adamgreig/linetime/README.md

# Linetime

Measure the line time. As precisely and accurately as feasible.
