adamgreig/linetime/hardware/sims/mains_lpf.csv

Title: mains lpf
Date: Mon Dec 19 00:59:21 2016
Plotname: AC Analysis
Flags: complex
No. Variables: 4
No. Points: 8001
Variables:
 | 0 | frequency | frequency grid=3
 | 1 | v(out) | voltage
 | 2 | db(v(out)/v(src)) | notype
 | 3 | ph(out) | voltage
Values:
0 | 1.000000000000000e+00,0.000000000000000e+00
 | 1.390163929116547e+00,-8.591466466225699e-05
 | -1.570659671680307e+01,0.0
 | -3.540983602049155e-03,0.0
1 | 1.002305238077900e+00,0.000000000000000e+00
 | 1.390163929092038e+00,-8.611271841716826e-05
 | -1.570659671687963e+01,0.0
 | -3.549146412260961e-03,0.0
2 | 1.004615790278395e+00,0.000000000000000e+00
 | 1.390163929067417e+00,-8.631122873312631e-05
 | -1.570659671695655e+01,0.0
 | -3.557328039693545e-03,0.0
3 | 1.006931668851804e+00,0.000000000000000e+00
 | 1.390163929042681e+00,-8.651019666261291e-05
 | -1.570659671703383e+01,0.0
 | -3.565528527725078e-03,0.0
4 | 1.009252886076684e+00,0.000000000000000e+00
 | 1.390163929017832e+00,-8.670962326053621e-05
 | -1.570659671711146e+01,0.0
 | -3.573747919833734e-03,0.0
5 | 1.011579454259898e+00,0.000000000000000e+00
 | 1.390163928992868e+00,-8.690950958423606e-05
 | -1.570659671718944e+01,0.0
 | -3.581986259597908e-03,0.0
6 | 1.013911385736679e+00,0.000000000000000e+00
 | 1.390163928967789e+00,-8.710985669348970e-05
 | -1.570659671726780e+01,0.0
 | -3.590243590696457e-03,0.0
7 | 1.016248692870695e+00,0.000000000000000e+00
 | 1.390163928942594e+00,-8.731066565051752e-05
 | -1.570659671734651e+01,0.0
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
 | -1.570659723946124e+01,0.0
 | -2.018942257629462e-02,0.0
757 | 5.714786366718442e+00,0.000000000000000e+00
 | 1.390163761018468e+00,-4.909838949434654e-04
 | -1.570659724195029e+01,0.0
 | -2.023596399812239e-02,0.0
758 | 5.727960309858063e+00,0.000000000000000e+00
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
