adamgreig/linetime/case/lcd-bracket/bracket.png

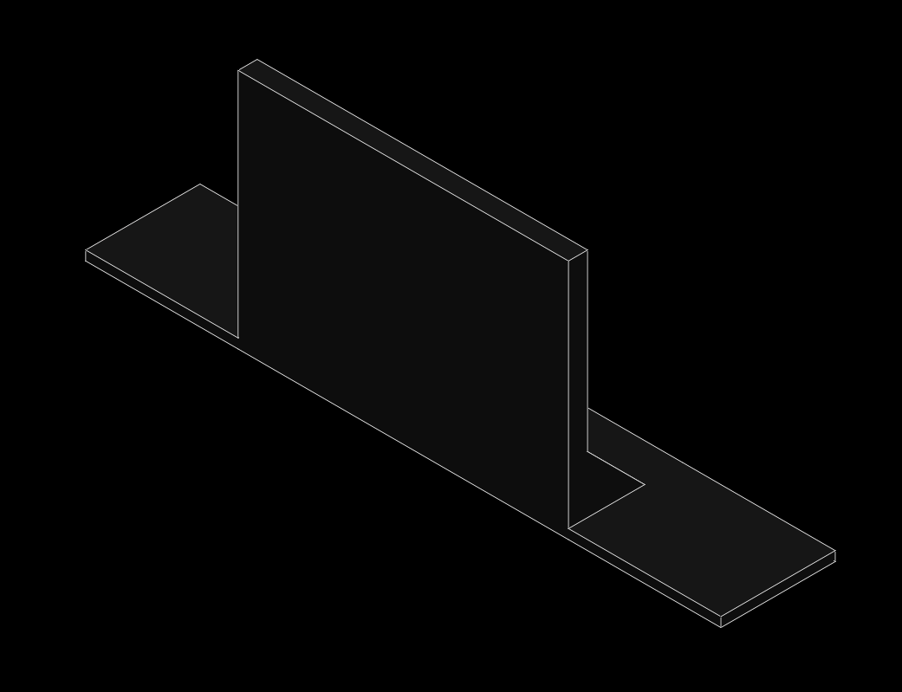
case/lcd-bracket/bracket.png
