adamgreig/linetime/case/back-panel/back-panel.dxf

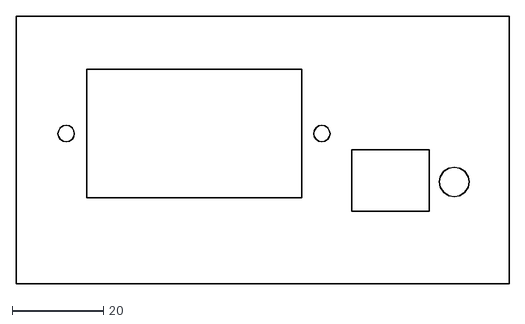
[picture p2: CAD file, 2017-03-29]
case/back-panel/back-panel.dxf
108.0 x 58.6
