adamgreig/linetime/case/front-panel/front_panel.dxf

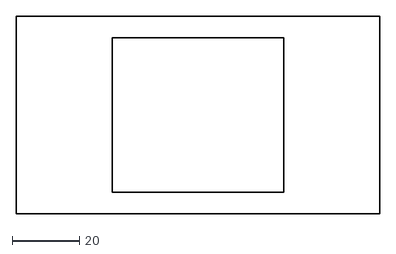
[picture p3: CAD file, 2017-03-29]
case/front-panel/front_panel.dxf
108.0 x 58.6
