adamgreig/linetime/case/lcd-bracket/bracket.stl

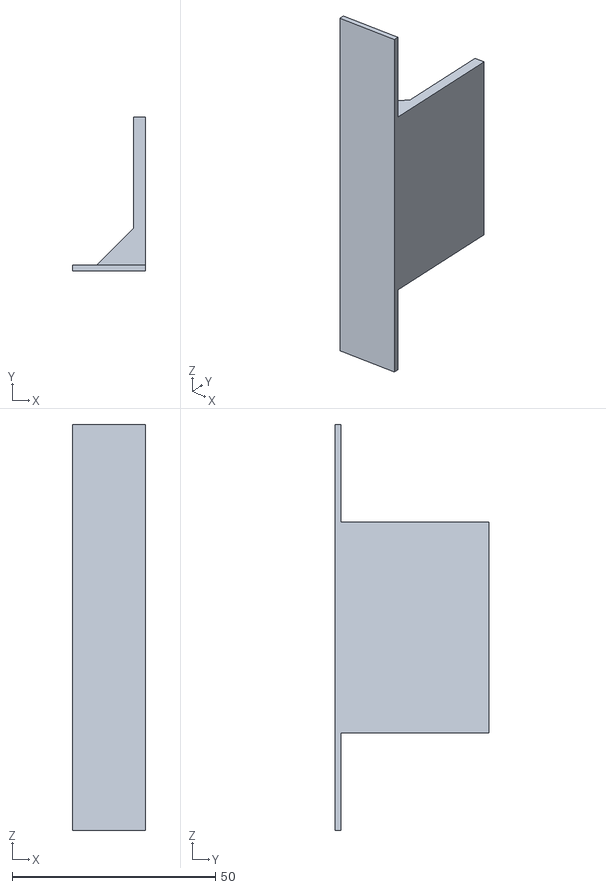
[picture p4: CAD file, 2017-03-29]
case/lcd-bracket/bracket.stl
18.0 x 38.0 x 100.0
