adamgreig/linetime/case/back-panel/export.dxf

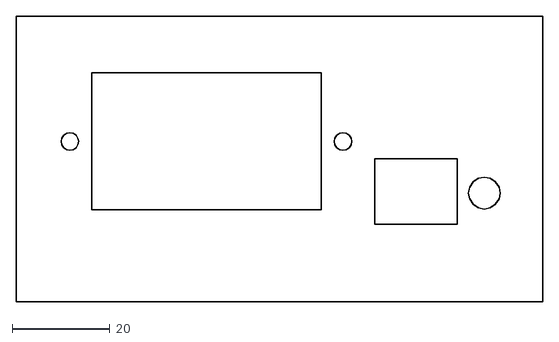
[picture p5: CAD file, 2017-03-29]
case/back-panel/export.dxf
108.0 x 58.6
