adamgreig/linetime/case/front-panel/export.dxf

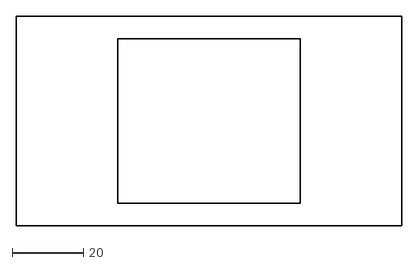
[picture p6: CAD file, 2017-03-29]
case/front-panel/export.dxf
108.0 x 58.6
