adamgreig/linetime/case/back-panel/back-panel.pdf

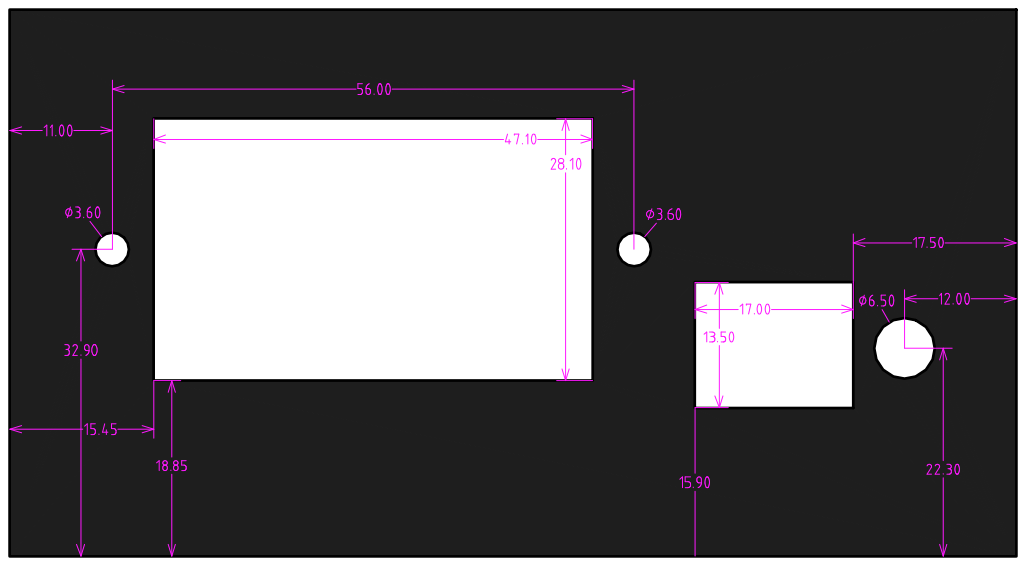
[picture p12: page 1]
