adamgreig/linetime/case/front-panel/front_panel.pdf

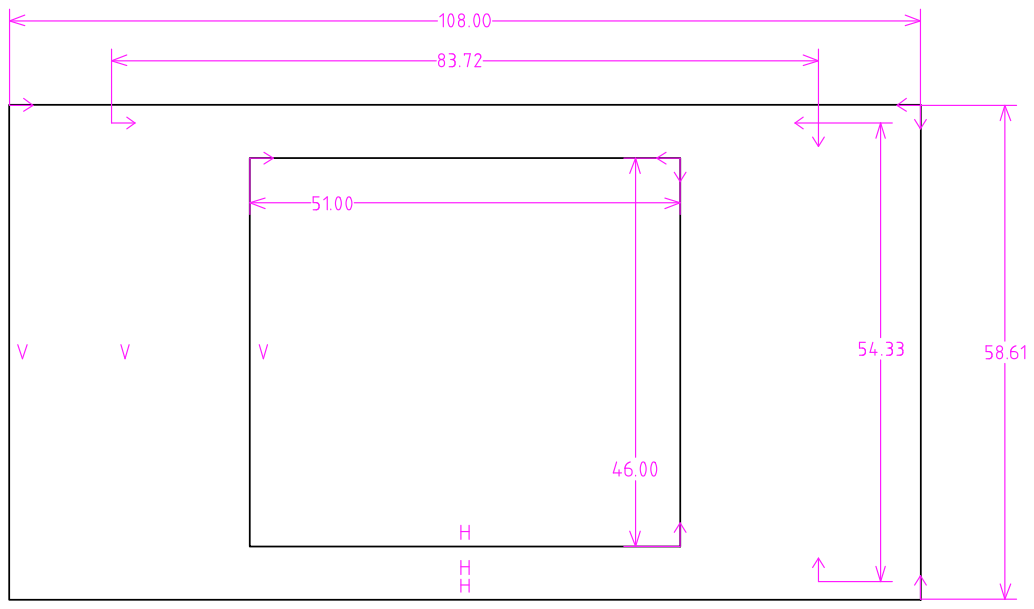
[picture p13: page 1]
