adamgreig/linetime/hardware/linetime.kicad_pcb

## KiCad design hardware/linetime.kicad_pcb (2016-12-19)

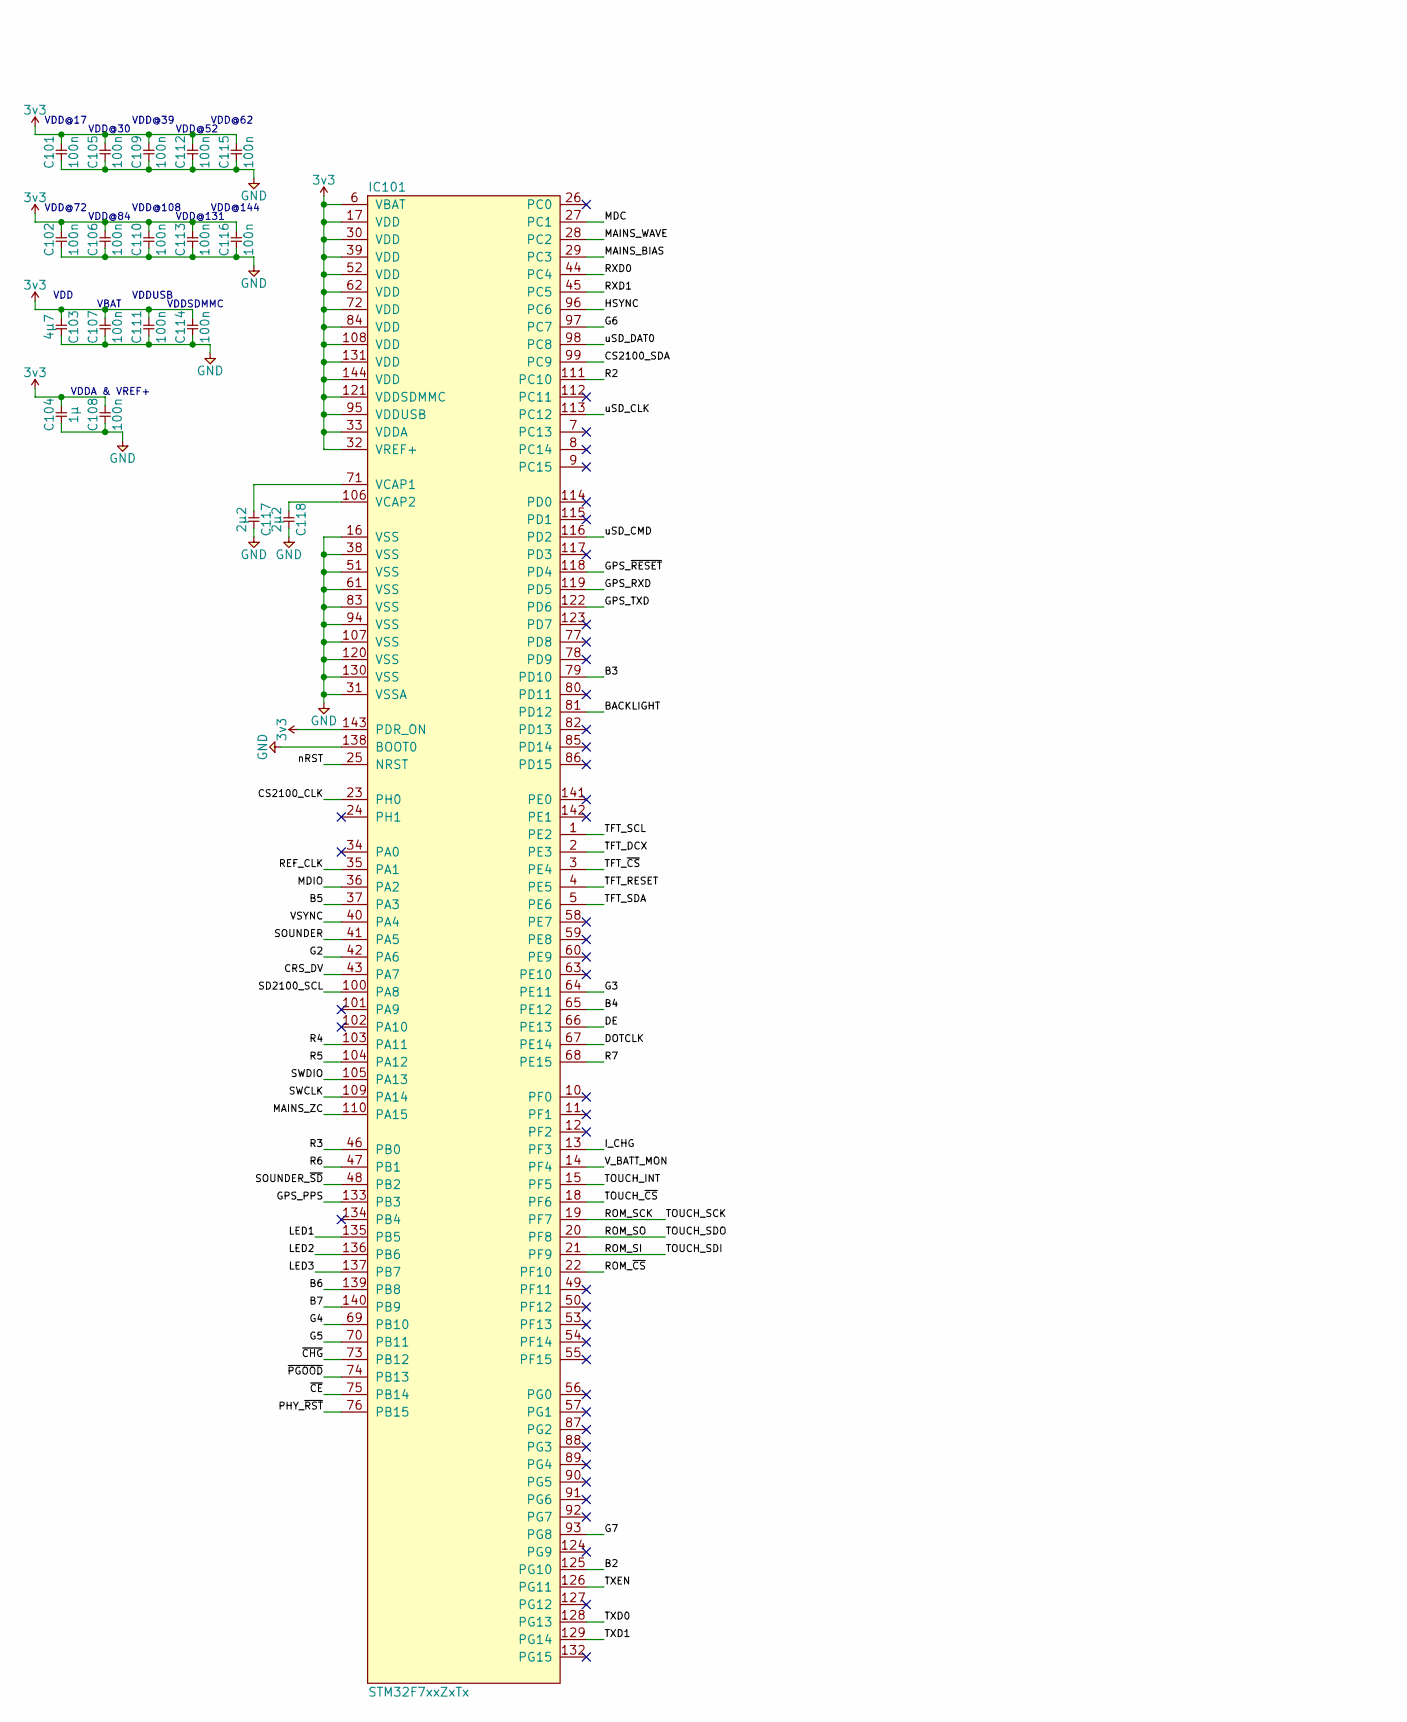
[picture p14: schematic linetime.sch, part in row 1, column 1]

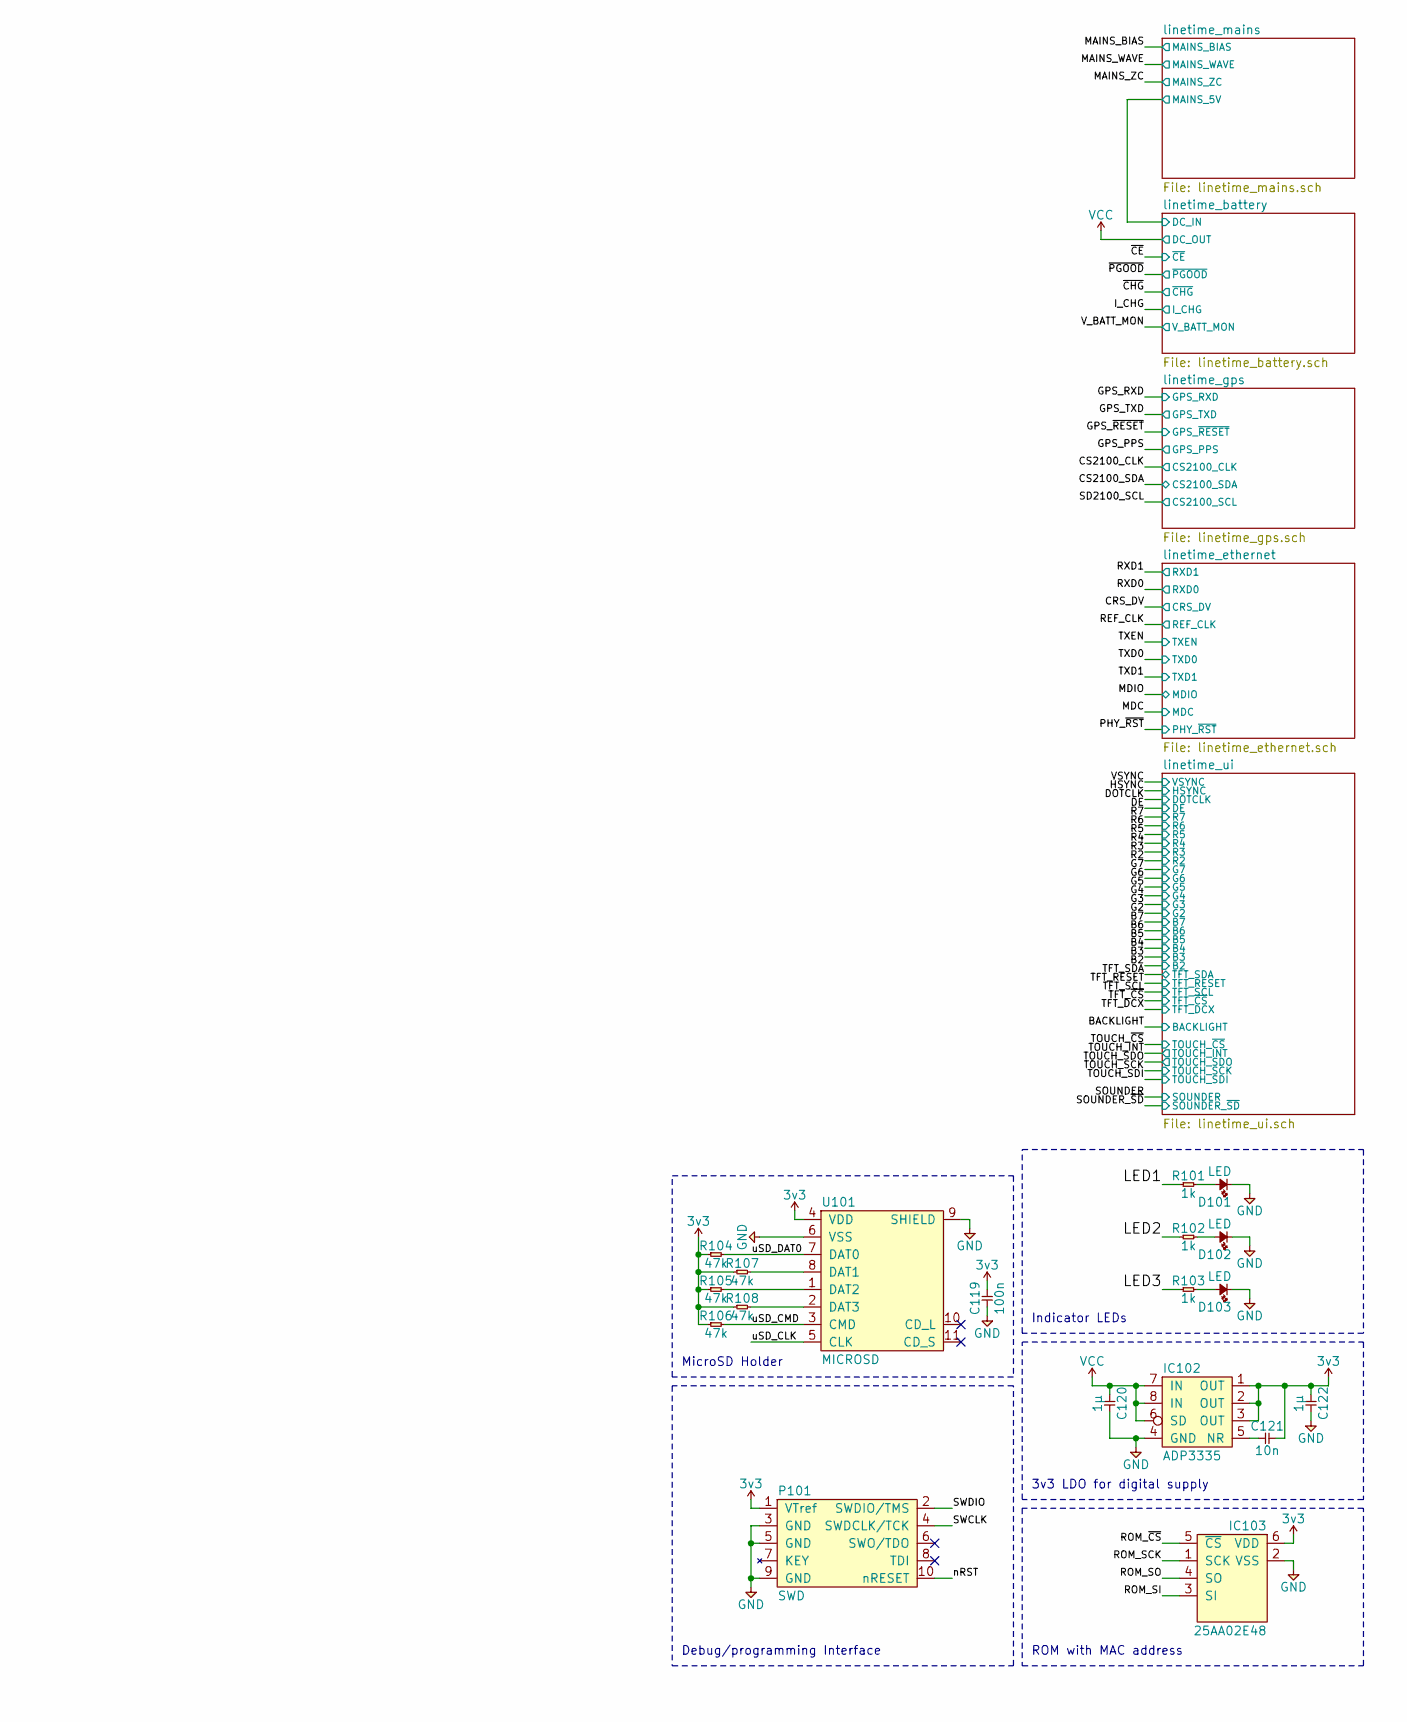
[picture p15: schematic linetime.sch, part in row 1, column 2]

Parts:
C101, C102, C105, C106, C107, C108, C109, C110, C111, C112, C113, C114, C115, C116, C119: 100n; 0603
C103: 4µ7; 0603
C104, C120, C122: 1µ; 0603
C117, C118: 2µ2; 0603
C121: 10n; 0603
D101, D102, D103: LED; 0603-LED
IC101: STM32F7xxZxTx; LQFP-144; Farnell 2535499
IC102: ADP3335; MSOP-8; Farnell 2067775
IC103: 25AA02E48; SOT-23-6; Farnell 1700995
P101: SWD; FTSH-105-01-F-D-K
R101, R102, R103: 1k; 0603
R104, R105, R106, R107, R108: 47k; 0603
U101: MICROSD; MICROSD_MOLEX_503398-1892; Farnell 2358234

Connections:
3v3: C101.1, C102.1, C103.1, C104.1, C105.1, C106.1, C107.1, C108.1, C109.1, C110.1, C111.1, C112.1, C113.1, C114.1, C115.1, C116.1, C119.1, C121.2, C122.1, IC101.6 (VBAT), IC101.17 (VDD), IC101.30 (VDD), IC101.32 (VREF+), IC101.33 (VDDA), IC101.39 (VDD), IC101.52 (VDD), IC101.62 (VDD), IC101.72 (VDD), IC101.84 (VDD), IC101.95 (VDDUSB), IC101.108 (VDD), IC101.121 (VDDSDMMC), IC101.131 (VDD), IC101.143 (PDR_ON), IC101.144 (VDD), IC102.1 (OUT), IC102.2 (OUT), IC102.3 (OUT), IC103.6 (VDD), P101.1 (VTref), R104.1, R105.1, R106.1, R107.1, R108.1, U101.4 (VDD); also elsewhere on the board
/B2: IC101.125 (PG10); also elsewhere on the board
/B3: IC101.79 (PD10); also elsewhere on the board
/B4: IC101.65 (PE12); also elsewhere on the board
/B5: IC101.37 (PA3); also elsewhere on the board
/B6: IC101.139 (PB8); also elsewhere on the board
/B7: IC101.140 (PB9); also elsewhere on the board
/BACKLIGHT: IC101.81 (PD12); also elsewhere on the board
/CRS_DV: IC101.43 (PA7); also elsewhere on the board
/CS2100_CLK: IC101.23 (PH0); also elsewhere on the board
/CS2100_SDA: IC101.99 (PC9); also elsewhere on the board
/DE: IC101.66 (PE13); also elsewhere on the board
/DOTCLK: IC101.67 (PE14); also elsewhere on the board
/G2: IC101.42 (PA6); also elsewhere on the board
/G3: IC101.64 (PE11); also elsewhere on the board
/G4: IC101.69 (PB10); also elsewhere on the board
/G5: IC101.70 (PB11); also elsewhere on the board
/G6: IC101.97 (PC7); also elsewhere on the board
/G7: IC101.93 (PG8); also elsewhere on the board
/GPS_PPS: IC101.133 (PB3); also elsewhere on the board
/GPS_RXD: IC101.119 (PD5); also elsewhere on the board
/GPS_TXD: IC101.122 (PD6); also elsewhere on the board
/GPS_~RESET: IC101.118 (PD4); also elsewhere on the board
/HSYNC: IC101.96 (PC6); also elsewhere on the board
/I_CHG: IC101.13 (PF3); also elsewhere on the board
/LED1: IC101.135 (PB5), R101.1
/LED2: IC101.136 (PB6), R102.1
/LED3: IC101.137 (PB7), R103.1
/MAINS_BIAS: IC101.29 (PC3); also elsewhere on the board
/MAINS_WAVE: IC101.28 (PC2); also elsewhere on the board
/MAINS_ZC: IC101.110 (PA15); also elsewhere on the board
/MDC: IC101.27 (PC1); also elsewhere on the board
/MDIO: IC101.36 (PA2); also elsewhere on the board
/PHY_~RST: IC101.76 (PB15); also elsewhere on the board
/R2: IC101.111 (PC10); also elsewhere on the board
/R3: IC101.46 (PB0); also elsewhere on the board
/R4: IC101.103 (PA11); also elsewhere on the board
/R5: IC101.104 (PA12); also elsewhere on the board
/R6: IC101.47 (PB1); also elsewhere on the board
/R7: IC101.68 (PE15); also elsewhere on the board
/REF_CLK: IC101.35 (PA1); also elsewhere on the board
/ROM_SCK: IC101.19 (PF7), IC103.1 (SCK); also elsewhere on the board
/ROM_SI: IC101.21 (PF9), IC103.3 (SI); also elsewhere on the board
/ROM_SO: IC101.20 (PF8), IC103.4 (SO); also elsewhere on the board
/ROM_~CS: IC101.22 (PF10), IC103.5 (~CS)
/RXD0: IC101.44 (PC4); also elsewhere on the board
/RXD1: IC101.45 (PC5); also elsewhere on the board
/SD2100_SCL: IC101.100 (PA8); also elsewhere on the board
/SOUNDER: IC101.41 (PA5); also elsewhere on the board
/SOUNDER_~SD: IC101.48 (PB2); also elsewhere on the board
/SWCLK: IC101.109 (PA14), P101.4 (SWDCLK/TCK)
/SWDIO: IC101.105 (PA13), P101.2 (SWDIO/TMS)
/TFT_DCX: IC101.2 (PE3); also elsewhere on the board
/TFT_RESET: IC101.4 (PE5); also elsewhere on the board
/TFT_SCL: IC101.1 (PE2); also elsewhere on the board
/TFT_SDA: IC101.5 (PE6); also elsewhere on the board
/TFT_~CS: IC101.3 (PE4); also elsewhere on the board
/TOUCH_INT: IC101.15 (PF5); also elsewhere on the board
/TOUCH_~CS: IC101.18 (PF6); also elsewhere on the board
/TXD0: IC101.128 (PG13); also elsewhere on the board
/TXD1: IC101.129 (PG14); also elsewhere on the board
/TXEN: IC101.126 (PG11); also elsewhere on the board
/VSYNC: IC101.40 (PA4); also elsewhere on the board
/V_BATT_MON: IC101.14 (PF4); also elsewhere on the board
/nRST: IC101.25 (NRST), P101.10 (nRESET)
/uSD_CLK: IC101.113 (PC12), U101.5 (CLK)
/uSD_CMD: IC101.116 (PD2), R106.2, U101.3 (CMD)
/uSD_DAT0: IC101.98 (PC8), R104.2, U101.7 (DAT0)
/~CE: IC101.75 (PB14); also elsewhere on the board
/~CHG: IC101.73 (PB12); also elsewhere on the board
/~PGOOD: IC101.74 (PB13); also elsewhere on the board
GND: C101.2, C102.2, C103.2, C104.2, C105.2, C106.2, C107.2, C108.2, C109.2, C110.2, C111.2, C112.2, C113.2, C114.2, C115.2, C116.2, C117.2, C118.2, C119.2, C120.2, C122.2, D101.1, D102.1, D103.1, IC101.16 (VSS), IC101.31 (VSSA), IC101.38 (VSS), IC101.51 (VSS), IC101.61 (VSS), IC101.83 (VSS), IC101.94 (VSS), IC101.107 (VSS), IC101.120 (VSS), IC101.130 (VSS), IC101.138 (BOOT0), IC102.4 (GND), IC103.2 (VSS), P101.3 (GND), P101.5 (GND), P101.9 (GND), U101.6 (VSS), U101.9 (SHIELD); also elsewhere on the board
unnamed: C117.1, IC101.71 (VCAP1)
unnamed: C118.1, IC101.106 (VCAP2)
unnamed: C121.1, IC102.5 (NR)
unnamed: D101.2, R101.2
unnamed: D102.2, R102.2
unnamed: D103.2, R103.2
unnamed: R105.2, U101.1 (DAT2)
unnamed: R107.2, U101.8 (DAT1)
unnamed: R108.2, U101.2 (DAT3)
VCC: C120.1, IC102.6 (SD), IC102.7 (IN), IC102.8 (IN); also elsewhere on the board

Notes on the sheet:
3v3 LDO for digital supply
ROM with MAC address
MicroSD Holder
Debug/programming Interface
VDDA & VREF+
VDDUSB
VDDSDMMC
VBAT
VDD
VDD@17
VDD@30
VDD@39
VDD@52
VDD@62
VDD@72
VDD@84
VDD@108
VDD@131
VDD@144
Indicator LEDs

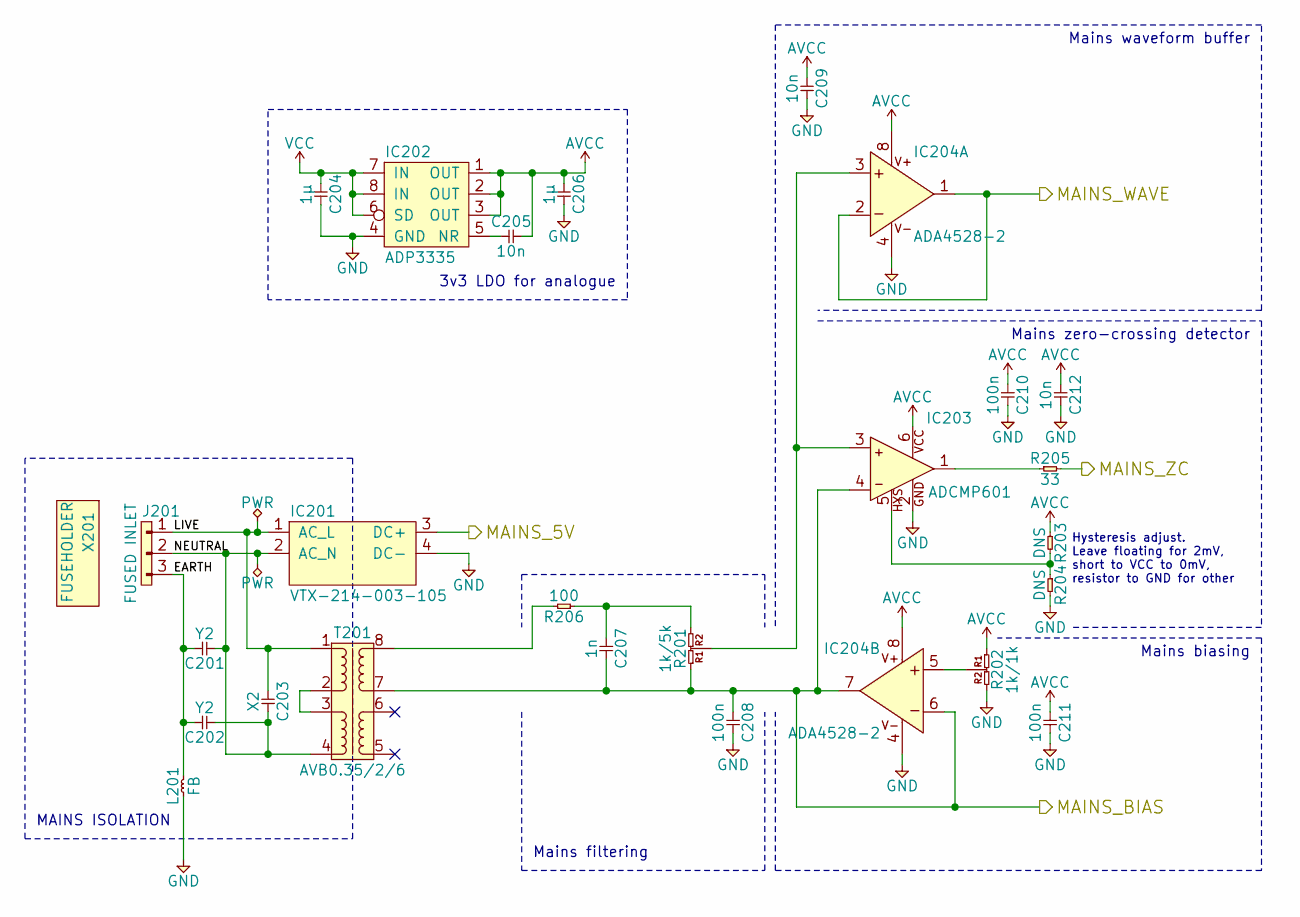
[picture p16: schematic linetime_mains.sch, Linetime]

Parts:
C201, C202: Y2; B32921; Farnell 2395807
C203: X2; B32921; Farnell 2112770
C204, C206: 1µ; 0603
C205, C209, C212: 10n; 0603
C207: 1n; 0603
C208, C210, C211: 100n; 0603
IC201: VTX-214-003-105; VTX-214-003-1xx; Farnell 2401030
IC202: ADP3335; MSOP-8; Farnell 2067775
IC203: ADCMP601; SC-70-6; Farnell 1331025
IC204: ADA4528-2; MSOP-8; Farnell 2213573
J201: FUSED INLET; DD21.01xx.1111; Farnell 1517985
L201: FB; 0603; Farnell 1669708
R201: 1k/5k; SOT-23; Farnell 2325454
R202: 1k/1k; SOT-23; Farnell 1203390
R203, R204: DNS; 0603
R205: 33; 0603
R206: 100; 0603
T201: AVB0.35/2/6; AVB0.35_2_X; Farnell 1131455
X201: FUSEHOLDER; Farnell 1144906

Connections:
/MAINS_BIAS: C207.2, C208.1, IC203.4 (-), IC204.6 (-), IC204.7 (OUT), R201.1, T201.7; also elsewhere on the board
/MAINS_WAVE: IC204.1 (OUT), IC204.2 (-); also elsewhere on the board
/MAINS_ZC: R205.2; also elsewhere on the board
/linetime_battery/DC_IN: IC201.3 (DC+); also elsewhere on the board
/linetime_mains/EARTH: C201.2, C202.2, J201.3, L201.2
/linetime_mains/LIVE: C203.1, IC201.1 (AC_L), J201.1, T201.1
/linetime_mains/NEUTRAL: C201.1, C202.1, C203.2, IC201.2 (AC_N), J201.2, T201.4
AVCC: C205.2, C206.1, C209.1, C210.1, C211.1, C212.1, IC202.1 (OUT), IC202.2 (OUT), IC202.3 (OUT), IC203.6 (VCC), IC204.8 (V+), R202.1, R203.1
GND: C204.2, C206.2, C208.2, C209.2, C210.2, C211.2, C212.2, IC201.4 (DC-), IC202.4 (GND), IC203.2 (GND), IC204.4 (V-), L201.1, R202.2, R204.2; also elsewhere on the board
unnamed: C205.1, IC202.5 (NR)
unnamed: C207.1, R201.2, R206.1
unnamed: IC203.1 (Q), R205.1
unnamed: IC203.3 (+), IC204.3 (+), R201.3
unnamed: IC203.5 (LE/HYS), R203.2, R204.1
unnamed: IC204.5 (+), R202.3
unnamed: R206.2, T201.8
unnamed: T201.2, T201.3
VCC: C204.1, IC202.6 (SD), IC202.7 (IN), IC202.8 (IN); also elsewhere on the board

Notes on the sheet:
MAINS ISOLATION
Hysteresis adjust. Leave floating for 2mV, short to VCC to 0mV, resistor to GND for other
Mains waveform buffer
Mains zero-crossing detector
Mains biasing
Mains filtering
3v3 LDO for analogue

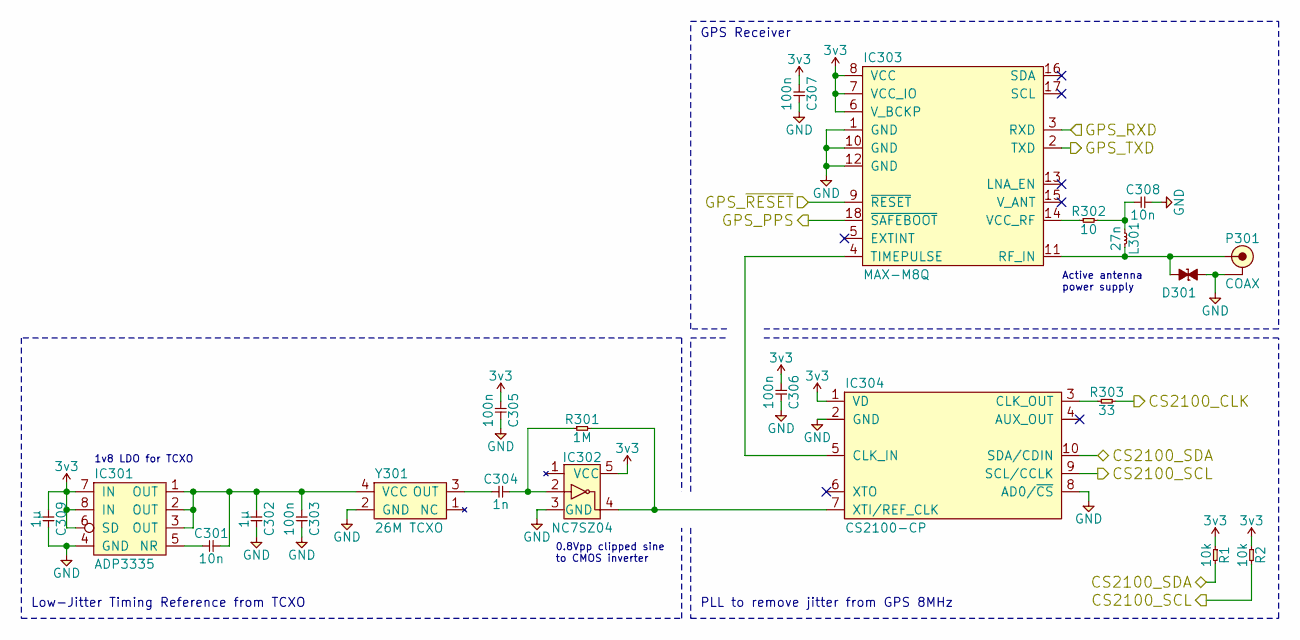
[picture p17: schematic linetime_gps.sch, Linetime]

Parts:
C301, C308: 10n; 0603
C302, C309: 1µ; 0603
C303, C305, C306, C307: 100n; 0603
C304: 1n; 0603
D301: ESD_DIODE; 0402; Farnell 2368169
IC301: ADP3335; MSOP-8; Farnell 2376932
IC302: NC7SZ04; SOT-23-5; Farnell 1417667
IC303: MAX-M8Q
IC304: CS2100-CP; MSOP-10; Mouser 777-CS2100CP-CZZ
L301: 27n; 0603
P301: COAX; SMA-PTH; Farnell 2112448
R1, R2: 10k; 0603
R301: 1M; 0603
R302: 10; 0603
R303: 33; 0603
Y301: 26M TCXO; TG-5006CG; Farnell 2405785

Connections:
3v3: C305.1, C306.1, C307.1, C309.1, IC301.6 (SD), IC301.7 (IN), IC301.8 (IN), IC302.5 (VCC), IC303.6 (V_BCKP), IC303.7 (VCC_IO), IC303.8 (VCC), IC304.1 (VD), R1.1, R2.1; also elsewhere on the board
/CS2100_CLK: R303.2; also elsewhere on the board
/CS2100_SDA: IC304.10 (SDA/CDIN), R1.2; also elsewhere on the board
/GPS_PPS: IC303.18 (~SAFEBOOT); also elsewhere on the board
/GPS_RXD: IC303.3 (RXD); also elsewhere on the board
/GPS_TXD: IC303.2 (TXD); also elsewhere on the board
/GPS_~RESET: IC303.9 (~RESET); also elsewhere on the board
/SD2100_SCL: IC304.9 (SCL/CCLK), R2.2; also elsewhere on the board
GND: C302.2, C303.2, C305.2, C306.2, C307.2, C308.2, C309.2, D301.1, IC301.4 (GND), IC302.3 (GND), IC303.1 (GND), IC303.10 (GND), IC303.12 (GND), IC304.2 (GND), IC304.8 (AD0/~CS), P301.2 (GND), Y301.2 (GND); also elsewhere on the board
unnamed: C301.1, IC301.5 (NR)
unnamed: C301.2, C302.1, C303.1, IC301.1 (OUT), IC301.2 (OUT), IC301.3 (OUT), Y301.4 (VCC)
unnamed: C304.1, Y301.3 (OUT)
unnamed: C304.2, IC302.2, R301.1
unnamed: C308.1, L301.1, R302.2
unnamed: D301.2, IC303.11 (RF_IN), L301.2, P301.1 (RF)
unnamed: IC302.4, IC304.7 (XTI/REF_CLK), R301.2
unnamed: IC303.4 (TIMEPULSE), IC304.5 (CLK_IN)
unnamed: IC303.14 (VCC_RF), R302.1
unnamed: IC304.3 (CLK_OUT), R303.1

Notes on the sheet:
1v8 LDO for TCXO
0.8Vpp clipped sine to CMOS inverter
Low-Jitter Timing Reference from TCXO
PLL to remove jitter from GPS 8MHz
GPS Receiver
Active antenna power supply

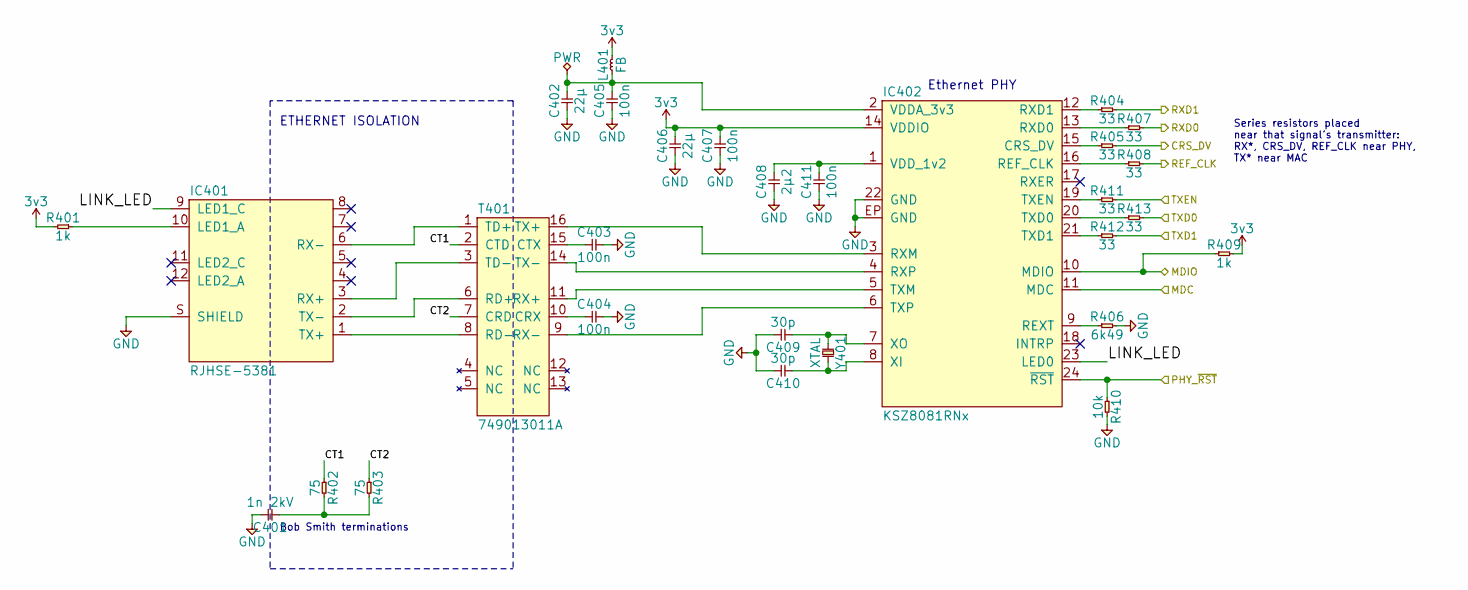
[picture p18: schematic linetime_ethernet.sch, Linetime]

Parts:
C401: 1n 2kV; 1206; Farnell 1855909
C402, C406: 22µ; 0603
C403, C404, C405, C407, C411: 100n; 0603
C408: 2µ2; 0603
C409, C410: 30p; 0603
IC401: RJHSE-5381; RJHSE-538X; Farnell 1462758
IC402: KSZ8081RNx; QFN-24-EP-MICREL; Farnell 2509802
L401: FB; 0603; Farnell 1669708
R401, R409: 1k; 0603
R402, R403: 75; 0603; Farnell 2059571
R404, R405, R407, R408, R411, R412, R413: 33; 0603
R406: 6k49; 0603
R410: 10k; 0603
T401: 749013011A; 749010012A; Farnell 2422553
Y401: XTAL; XTAL-50x32; Farnell 2101328

Connections:
3v3: C406.2, C407.2, IC402.14 (VDDIO), L401.2, R401.2, R409.2; also elsewhere on the board
/CRS_DV: R405.2; also elsewhere on the board
/MDC: IC402.11 (MDC); also elsewhere on the board
/MDIO: IC402.10 (MDIO), R409.1; also elsewhere on the board
/PHY_~RST: IC402.24 (~RST), R410.1; also elsewhere on the board
/REF_CLK: R408.2; also elsewhere on the board
/RXD0: R407.2; also elsewhere on the board
/RXD1: R404.2; also elsewhere on the board
/TXD0: R413.2; also elsewhere on the board
/TXD1: R412.2; also elsewhere on the board
/TXEN: R411.2; also elsewhere on the board
/linetime_ethernet/CT1: R402.1, T401.2 (CTD)
/linetime_ethernet/CT2: R403.1, T401.7 (CRD)
/linetime_ethernet/LINK_LED: IC401.9 (LED1_C), IC402.23 (LED0)
GND: C401.2, C402.1, C403.2, C404.2, C405.1, C406.1, C407.1, C408.1, C409.2, C410.2, C411.1, IC401.S (SHIELD), IC402.22 (GND), IC402.EP (GND), R406.2, R410.2; also elsewhere on the board
unnamed: C401.1, R402.2, R403.2
unnamed: C402.2, C405.2, IC402.2 (VDDA_3v3), L401.1
unnamed: C403.1, T401.15 (CTX)
unnamed: C404.1, T401.10 (CRX)
unnamed: C408.2, C411.2, IC402.1 (VDD_1v2)
unnamed: C409.1, IC402.7 (XO), Y401.1
unnamed: C410.1, IC402.8 (XI), Y401.2
unnamed: IC401.1 (TX+), T401.8 (RD-)
unnamed: IC401.2 (TX-), T401.6 (RD+)
unnamed: IC401.3 (RX+), T401.3 (TD-)
unnamed: IC401.6 (RX-), T401.1 (TD+)
unnamed: IC401.10 (LED1_A), R401.1
unnamed: IC402.3 (RXM), T401.16 (TX+)
unnamed: IC402.4 (RXP), T401.14 (TX-)
unnamed: IC402.5 (TXM), T401.11 (RX+)
unnamed: IC402.6 (TXP), T401.9 (RX-)
unnamed: IC402.9 (REXT), R406.1
unnamed: IC402.12 (RXD1), R404.1
unnamed: IC402.13 (RXD0), R407.1
unnamed: IC402.15 (CRS_DV), R405.1
unnamed: IC402.16 (REF_CLK), R408.1
unnamed: IC402.19 (TXEN), R411.1
unnamed: IC402.20 (TXD0), R413.1
unnamed: IC402.21 (TXD1), R412.1

Notes on the sheet:
Bob Smith terminations
ETHERNET ISOLATION
Ethernet PHY
Series resistors placed near that signal's transmitter: RX*, CRS_DV, REF_CLK near PHY, TX* near MAC

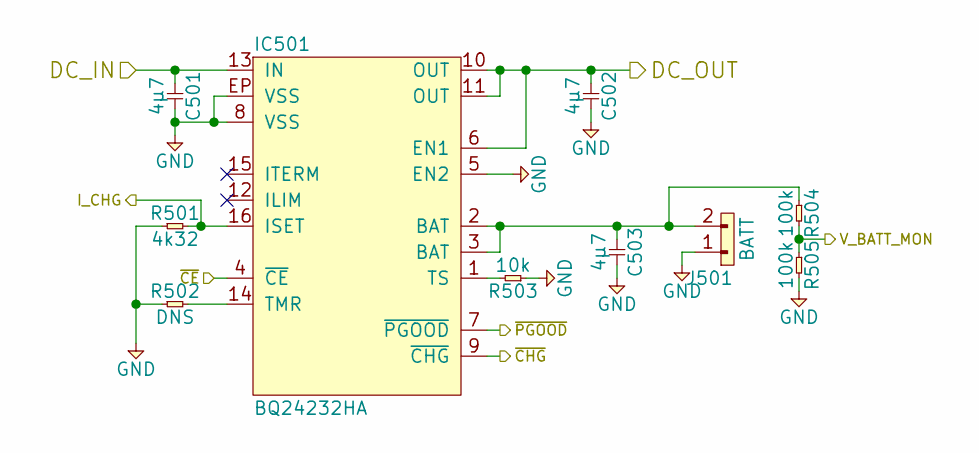
[picture p19: schematic linetime_battery.sch, Linetime]

Parts:
C501, C502, C503: 4µ7; 0603
IC501: BQ24232HA; QFN-16-EP-TI; Farnell 2576286
J501: BATT; S02B-PASK-2
R501: 4k32; 0603
R502: DNS; 0603
R503: 10k; 0603
R504, R505: 100k; 0603

Connections:
/I_CHG: IC501.16 (ISET), R501.2; also elsewhere on the board
/V_BATT_MON: R504.2, R505.1; also elsewhere on the board
/linetime_battery/DC_IN: C501.1, IC501.13 (IN); also elsewhere on the board
/~CE: IC501.4 (~CE); also elsewhere on the board
/~CHG: IC501.9 (~CHG); also elsewhere on the board
/~PGOOD: IC501.7 (~PGOOD); also elsewhere on the board
GND: C501.2, C502.2, C503.2, IC501.5 (EN2), IC501.8 (VSS), IC501.EP (VSS), J501.1, R501.1, R502.1, R503.1, R505.2; also elsewhere on the board
unnamed: C503.1, IC501.2 (BAT), IC501.3 (BAT), J501.2, R504.1
unnamed: IC501.1 (TS), R503.2
unnamed: IC501.14 (TMR), R502.2
VCC: C502.1, IC501.6 (EN1), IC501.10 (OUT), IC501.11 (OUT); also elsewhere on the board

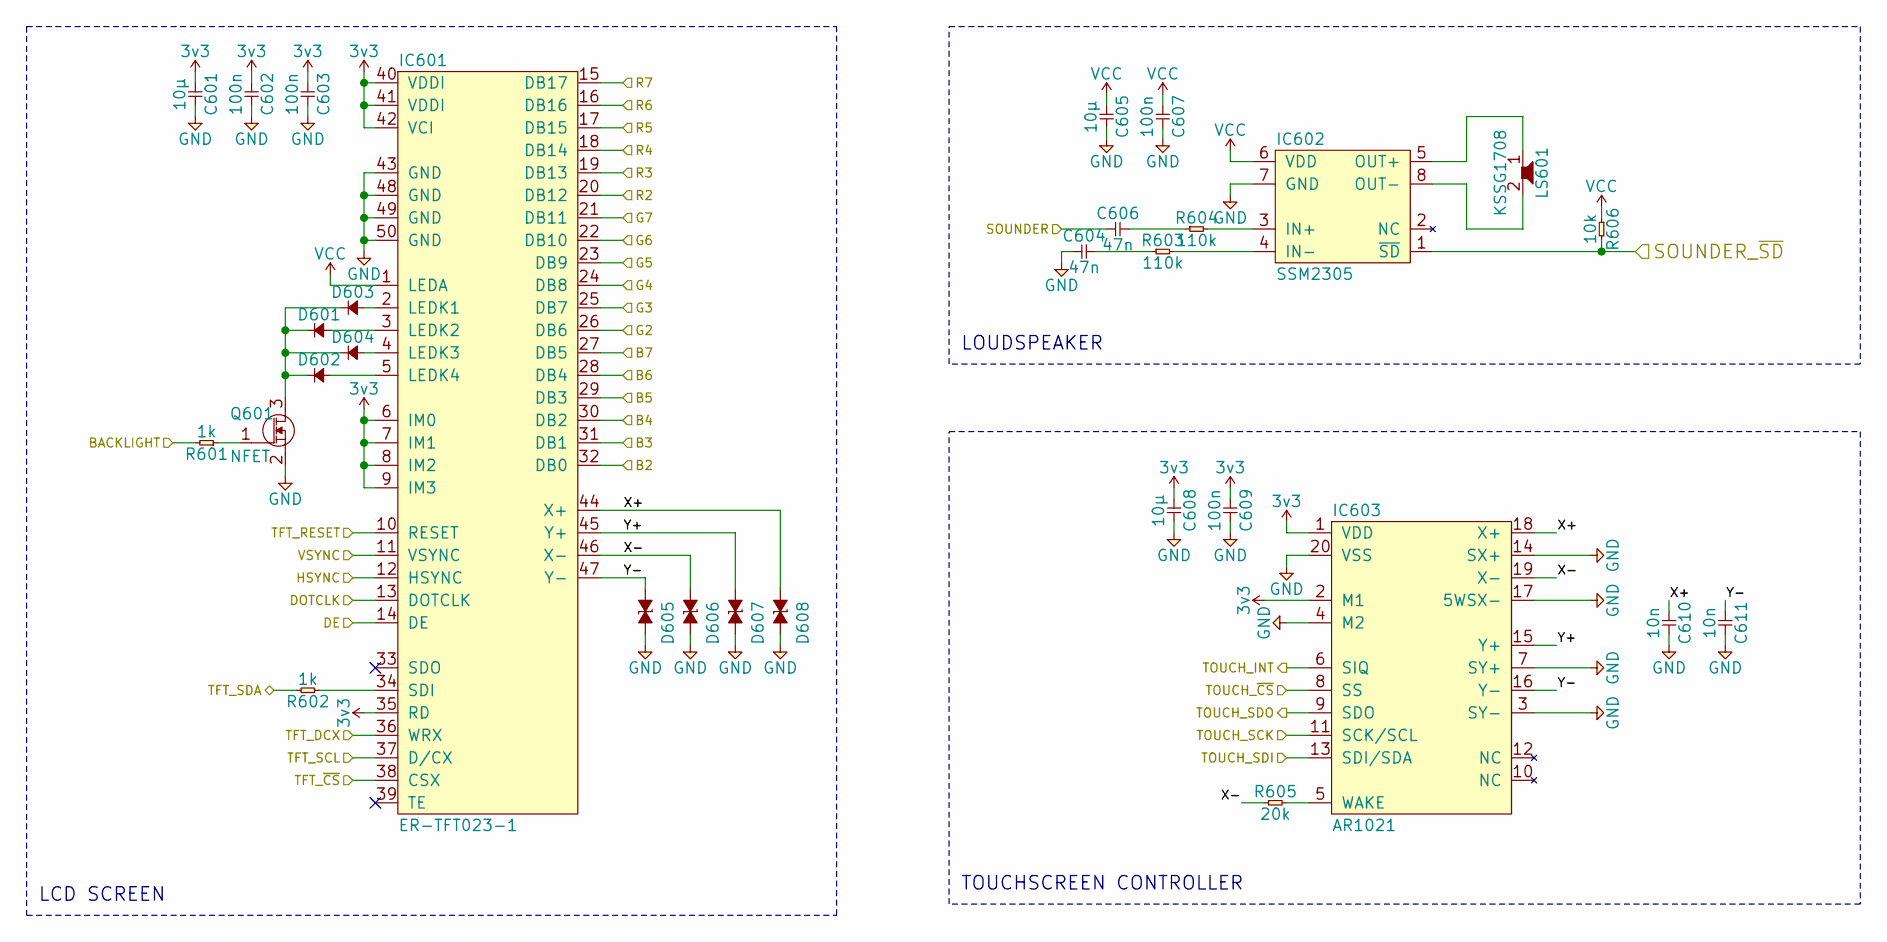
[picture p20: schematic linetime_ui.sch, Linetime]

Parts:
C601, C605, C608: 10µ; 0603
C602, C603, C607, C609: 100n; 0603
C604, C606: 47n; 0603
C610, C611: 10n; 0603
D601, D602, D603, D604: SOD-123; Farnell 1794973
D605, D606, D607, D608: ESD_DIODE; 0402; Farnell 2368169
IC601: ER-TFT023-1; ER-CON50HT-1
IC602: SSM2305; MSOP-8; Farnell 2074853
IC603: AR1021; SSOP-20; Farnell 2218568
LS601: KSSG1708; Farnell 1502738
Q601: NFET; SOT-23; Farnell 2069541
R601, R602: 1k; 0603
R603, R604: 110k; 0603
R605: 20k; 0603
R606: 10k; 0603

Connections:
3v3: C601.1, C602.1, C603.1, C608.1, C609.1, IC601.6 (IM0), IC601.7 (IM1), IC601.8 (IM2), IC601.9 (IM3), IC601.35 (RD), IC601.40 (VDDI), IC601.41 (VDDI), IC601.42 (VCI), IC603.1 (VDD), IC603.2 (M1); also elsewhere on the board
/B2: IC601.32 (DB0); also elsewhere on the board
/B3: IC601.31 (DB1); also elsewhere on the board
/B4: IC601.30 (DB2); also elsewhere on the board
/B5: IC601.29 (DB3); also elsewhere on the board
/B6: IC601.28 (DB4); also elsewhere on the board
/B7: IC601.27 (DB5); also elsewhere on the board
/BACKLIGHT: R601.2; also elsewhere on the board
/DE: IC601.14 (DE); also elsewhere on the board
/DOTCLK: IC601.13 (DOTCLK); also elsewhere on the board
/G2: IC601.26 (DB6); also elsewhere on the board
/G3: IC601.25 (DB7); also elsewhere on the board
/G4: IC601.24 (DB8); also elsewhere on the board
/G5: IC601.23 (DB9); also elsewhere on the board
/G6: IC601.22 (DB10); also elsewhere on the board
/G7: IC601.21 (DB11); also elsewhere on the board
/HSYNC: IC601.12 (HSYNC); also elsewhere on the board
/R2: IC601.20 (DB12); also elsewhere on the board
/R3: IC601.19 (DB13); also elsewhere on the board
/R4: IC601.18 (DB14); also elsewhere on the board
/R5: IC601.17 (DB15); also elsewhere on the board
/R6: IC601.16 (DB16); also elsewhere on the board
/R7: IC601.15 (DB17); also elsewhere on the board
/ROM_SCK: IC603.11 (SCK/SCL); also elsewhere on the board
/ROM_SI: IC603.13 (SDI/SDA); also elsewhere on the board
/ROM_SO: IC603.9 (SDO); also elsewhere on the board
/SOUNDER: C606.1; also elsewhere on the board
/SOUNDER_~SD: IC602.1 (~SD), R606.2; also elsewhere on the board
/TFT_DCX: IC601.36 (WRX); also elsewhere on the board
/TFT_RESET: IC601.10 (RESET); also elsewhere on the board
/TFT_SCL: IC601.37 (D/CX); also elsewhere on the board
/TFT_SDA: R602.2; also elsewhere on the board
/TFT_~CS: IC601.38 (CSX); also elsewhere on the board
/TOUCH_INT: IC603.6 (SIQ); also elsewhere on the board
/TOUCH_~CS: IC603.8 (SS); also elsewhere on the board
/VSYNC: IC601.11 (VSYNC); also elsewhere on the board
/linetime_ui/X+: C610.1, D608.1, IC601.44 (X+), IC603.18 (X+)
/linetime_ui/X-: D606.1, IC601.46 (X-), IC603.19 (X-), R605.1
/linetime_ui/Y+: D607.1, IC601.45 (Y+), IC603.15 (Y+)
/linetime_ui/Y-: C611.1, D605.1, IC601.47 (Y-), IC603.16 (Y-)
GND: C601.2, C602.2, C603.2, C604.1, C605.2, C607.2, C608.2, C609.2, C610.2, C611.2, D605.2, D606.2, D607.2, D608.2, IC601.43 (GND), IC601.48 (GND), IC601.49 (GND), IC601.50 (GND), IC602.7 (GND), IC603.3 (SY-), IC603.4 (M2), IC603.7 (SY+), IC603.14 (SX+), IC603.17 (5WSX-), IC603.20 (VSS), Q601.2 (S); also elsewhere on the board
unnamed: C604.2, R603.1
unnamed: C606.2, R604.1
unnamed: D601.1, D602.1, D603.1, D604.1, Q601.3 (D)
unnamed: D601.2, IC601.3 (LEDK2)
unnamed: D602.2, IC601.5 (LEDK4)
unnamed: D603.2, IC601.2 (LEDK1)
unnamed: D604.2, IC601.4 (LEDK3)
unnamed: IC601.34 (SDI), R602.1
unnamed: IC602.3 (IN+), R604.2
unnamed: IC602.4 (IN-), R603.2
unnamed: IC602.5 (OUT+), LS601.1
unnamed: IC602.8 (OUT-), LS601.2
unnamed: IC603.5 (WAKE), R605.2
unnamed: Q601.1 (G), R601.1
VCC: C605.1, C607.1, IC601.1 (LEDA), IC602.6 (VDD), R606.1; also elsewhere on the board

Notes on the sheet:
LOUDSPEAKER
LCD SCREEN
TOUCHSCREEN CONTROLLER
