adamgreig/linetime/hardware/linetime.kicad_pcb

## KiCad design hardware/linetime.kicad_pcb (continued)

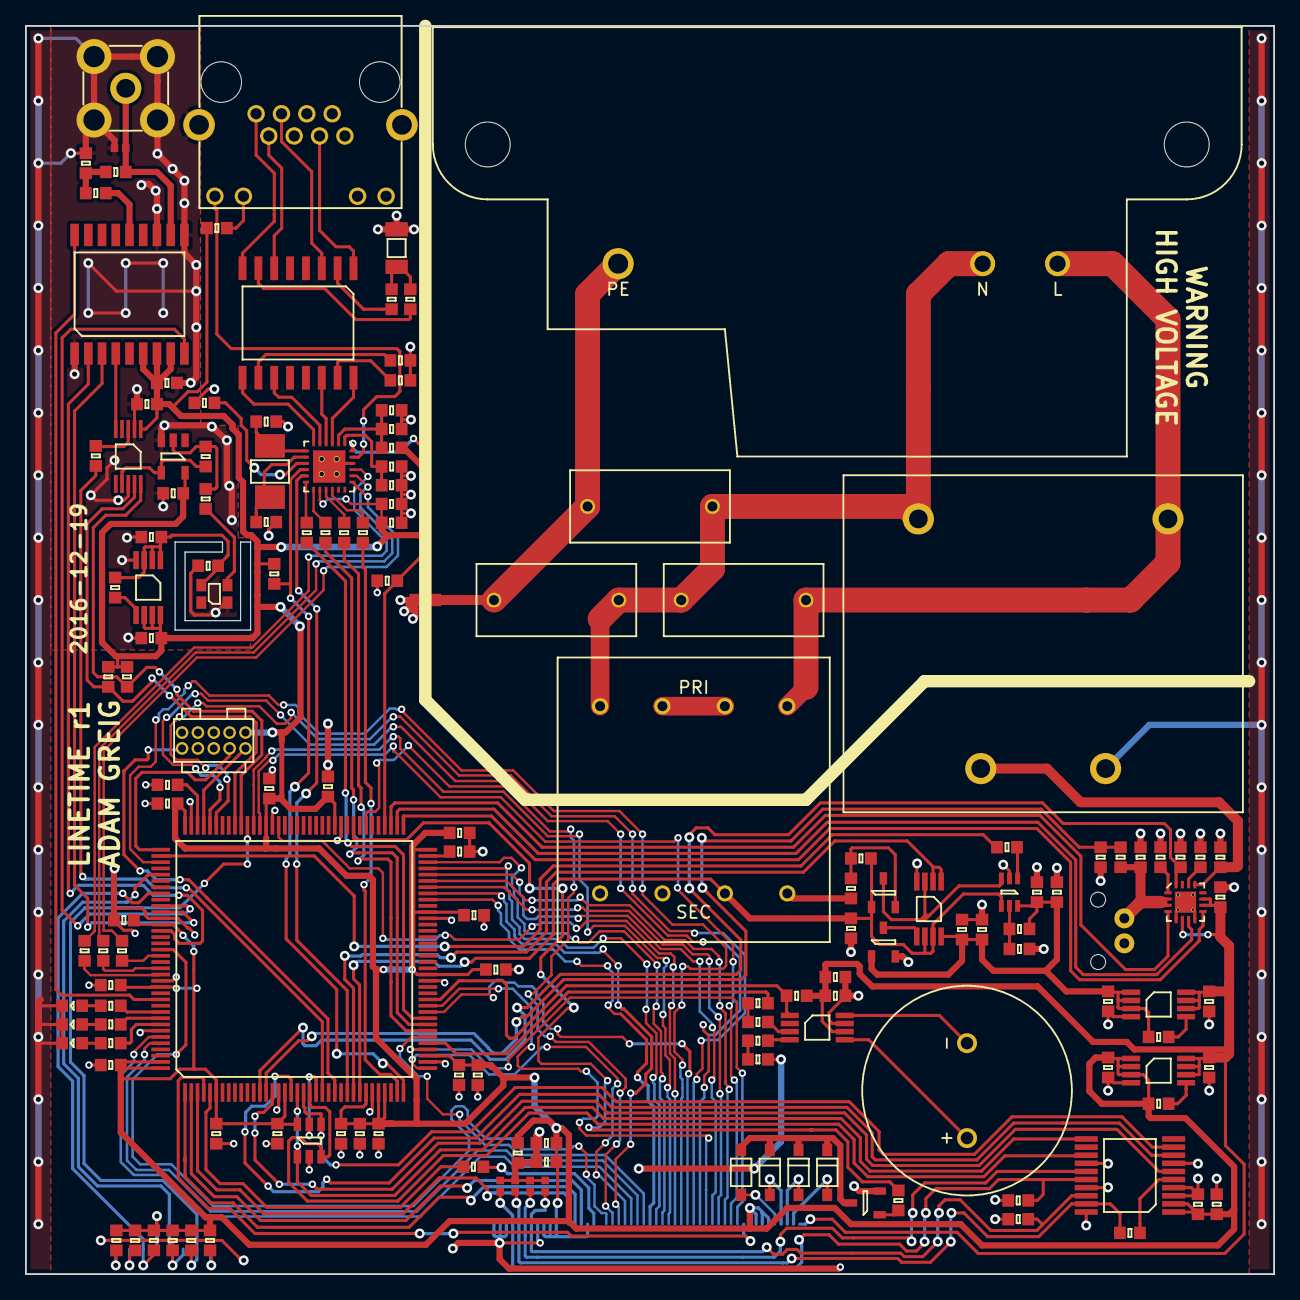
[picture p21: board linetime.kicad_pcb from above]

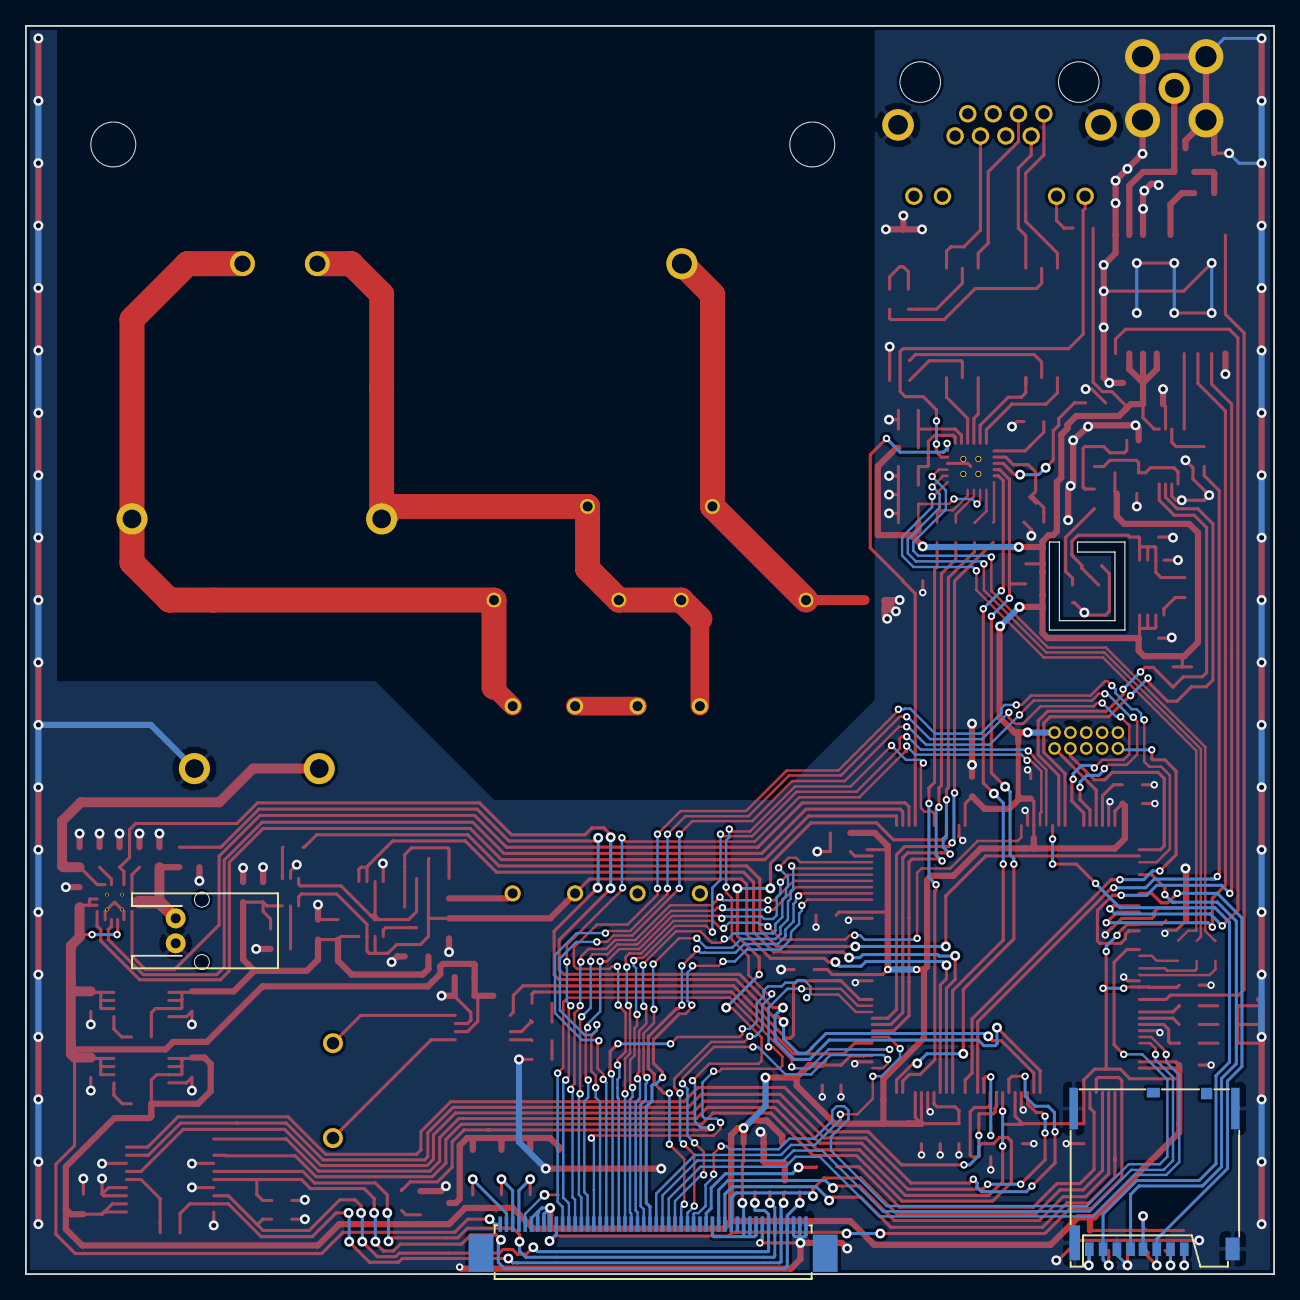
[picture p22: board linetime.kicad_pcb from below]

Board: 2 copper layers, 100.0 x 100.0 mm, 154 parts (3 on the bottom side), 153 nets.
