adamgreig/linetime/firmware/board.h

/*
    ChibiOS - Copyright (C) 2006..2016 Giovanni Di Sirio
    Licensed under the Apache License, Version 2.0 (the "License");
    you may not use this file except in compliance with the License.
    You may obtain a copy of the License at
    http://www.apache.org/licenses/LICENSE-2.0
    Unless required by applicable law or agreed to in writing, software
    distributed under the License is distributed on an "AS IS" BASIS,
    WITHOUT WARRANTIES OR CONDITIONS OF ANY KIND, either express or implied.
    See the License for the specific language governing permissions and
    limitations under the License.
*/

/*
    Generated by gen-board.h.py based on board.yaml
*/

#ifndef _BOARD_H_
#define _BOARD_H_


/*
    Setup for Linetime
*/

/*
    Board identifier
*/
#define BOARD_Linetime
#define BOARD_NAME                     "Linetime"

/*
    Board oscillators-related settings.
*/
#if !defined(STM32_LSECLK)
#define STM32_LSECLK                   0U
#endif

#if !defined(STM32_HSECLK)
#define STM32_HSECLK                   26000000U
#endif

#define STM32_HSE_BYPASS

/*
    Board voltages
    Required for performance limits calculation.
*/
#define STM32_VDD                      330U

/*
    Ethernet/PHY
*/
#define BOARD_PHY_ID                   0x00221560
#define BOARD_PHY_ADDRESS              0x00
#define BOARD_PHY_RMII
#define BOARD_PHY_RESET() {                                                   \
    palClearLine(LINE_PHY_RST);                                               \
    for(volatile uint32_t i=0; i<1920000; i++) asm("nop");                    \
    palSetLine(LINE_PHY_RST);                                                 \
}


/*
    MCU type as defined in the ST header.
*/
#define STM32F767xx

/*
    IO pins assignments.
*/

#define GPIOA_PIN0                     0U
#define GPIOA_RMII_REF_CLK             1U
#define GPIOA_RMII_MDIO                2U
#define GPIOA_LCD_B5                   3U
#define GPIOA_LCD_VSYNC                4U
#define GPIOA_SOUNDER                  5U
#define GPIOA_LCD_G2                   6U
#define GPIOA_RMII_CRS_DV              7U
#define GPIOA_CS2100_SCL               8U
#define GPIOA_PIN9                     9U
#define GPIOA_PIN10                    10U
#define GPIOA_LCD_R4                   11U
#define GPIOA_LCD_R5                   12U
#define GPIOA_SWDIO                    13U
#define GPIOA_SWCLK                    14U
#define GPIOA_MAINS_ZC                 15U

#define GPIOB_LCD_R3                   0U
#define GPIOB_LCD_R6                   1U
#define GPIOB_SOUNDER_SD               2U
#define GPIOB_GPS_PPS                  3U
#define GPIOB_PIN4                     4U
#define GPIOB_LED_RED                  5U
#define GPIOB_LED_YLW                  6U
#define GPIOB_LED_GRN                  7U
#define GPIOB_LCD_B6                   8U
#define GPIOB_LCD_B7                   9U
#define GPIOB_LCD_G4                   10U
#define GPIOB_LCD_G5                   11U
#define GPIOB_BATT_CHG                 12U
#define GPIOB_BATT_PGOOD               13U
#define GPIOB_BATT_CE                  14U
#define GPIOB_PHY_RST                  15U

#define GPIOC_PIN0                     0U
#define GPIOC_RMII_MDC                 1U
#define GPIOC_MAINS_WAVE               2U
#define GPIOC_MAINS_BIAS               3U
#define GPIOC_RMII_RXD0                4U
#define GPIOC_RMII_RXD1                5U
#define GPIOC_LCD_HSYNC                6U
#define GPIOC_LCD_G6                   7U
#define GPIOC_USD_DAT0                 8U
#define GPIOC_CS2100_SDA               9U
#define GPIOC_LCD_R2                   10U
#define GPIOC_PIN11                    11U
#define GPIOC_USD_CLK                  12U
#define GPIOC_PIN13                    13U
#define GPIOC_PIN14                    14U
#define GPIOC_PIN15                    15U

#define GPIOD_PIN0                     0U
#define GPIOD_PIN1                     1U
#define GPIOD_USD_CMD                  2U
#define GPIOD_PIN3                     3U
#define GPIOD_GPS_RESET                4U
#define GPIOD_GPS_RXD                  5U
#define GPIOD_GPS_TXD                  6U
#define GPIOD_PIN7                     7U
#define GPIOD_PIN8                     8U
#define GPIOD_PIN9                     9U
#define GPIOD_LCD_B3                   10U
#define GPIOD_PIN11                    11U
#define GPIOD_LCD_BACKLIGHT            12U
#define GPIOD_PIN13                    13U
#define GPIOD_PIN14                    14U
#define GPIOD_PIN15                    15U

#define GPIOE_PIN0                     0U
#define GPIOE_PIN1                     1U
#define GPIOE_LCD_SCL                  2U
#define GPIOE_LCD_DCX                  3U
#define GPIOE_LCD_CS                   4U
#define GPIOE_LCD_RST                  5U
#define GPIOE_LCD_SDA                  6U
#define GPIOE_PIN7                     7U
#define GPIOE_PIN8                     8U
#define GPIOE_PIN9                     9U
#define GPIOE_PIN10                    10U
#define GPIOE_LCD_G3                   11U
#define GPIOE_LCD_B4                   12U
#define GPIOE_LCD_DE                   13U
#define GPIOE_LCD_DOTCLK               14U
#define GPIOE_LCD_R7                   15U

#define GPIOF_PIN0                     0U
#define GPIOF_PIN1                     1U
#define GPIOF_PIN2                     2U
#define GPIOF_BATT_I_CHG               3U
#define GPIOF_BATT_V_MON               4U
#define GPIOF_TOUCH_INT                5U
#define GPIOF_TOUCH_CS                 6U
#define GPIOF_TOUCH_SCK                7U
#define GPIOF_TOUCH_SDO                8U
#define GPIOF_TOUCH_SDI                9U
#define GPIOF_EEPROM_CS                10U
#define GPIOF_PIN11                    11U
#define GPIOF_PIN12                    12U
#define GPIOF_PIN13                    13U
#define GPIOF_PIN14                    14U
#define GPIOF_PIN15                    15U

#define GPIOG_PIN0                     0U
#define GPIOG_PIN1                     1U
#define GPIOG_PIN2                     2U
#define GPIOG_PIN3                     3U
#define GPIOG_PIN4                     4U
#define GPIOG_PIN5                     5U
#define GPIOG_PIN6                     6U
#define GPIOG_PIN7                     7U
#define GPIOG_LCD_G7                   8U
#define GPIOG_PIN9                     9U
#define GPIOG_LCD_B2                   10U
#define GPIOG_RMII_TX_EN               11U
#define GPIOG_PIN12                    12U
#define GPIOG_RMII_TXD0                13U
#define GPIOG_RMII_TXD1                14U
#define GPIOG_PIN15                    15U

#define GPIOH_CS2100_CLK               0U
#define GPIOH_PIN1                     1U
#define GPIOH_PIN2                     2U
#define GPIOH_PIN3                     3U
#define GPIOH_PIN4                     4U
#define GPIOH_PIN5                     5U
#define GPIOH_PIN6                     6U
#define GPIOH_PIN7                     7U
#define GPIOH_PIN8                     8U
#define GPIOH_PIN9                     9U
#define GPIOH_PIN10                    10U
#define GPIOH_PIN11                    11U
#define GPIOH_PIN12                    12U
#define GPIOH_PIN13                    13U
#define GPIOH_PIN14                    14U
#define GPIOH_PIN15                    15U

#define GPIOI_PIN0                     0U
#define GPIOI_PIN1                     1U
#define GPIOI_PIN2                     2U
#define GPIOI_PIN3                     3U
#define GPIOI_PIN4                     4U
#define GPIOI_PIN5                     5U
#define GPIOI_PIN6                     6U
#define GPIOI_PIN7                     7U
#define GPIOI_PIN8                     8U
#define GPIOI_PIN9                     9U
#define GPIOI_PIN10                    10U
#define GPIOI_PIN11                    11U
#define GPIOI_PIN12                    12U
#define GPIOI_PIN13                    13U
#define GPIOI_PIN14                    14U
#define GPIOI_PIN15                    15U

#define GPIOJ_PIN0                     0U
#define GPIOJ_PIN1                     1U
#define GPIOJ_PIN2                     2U
#define GPIOJ_PIN3                     3U
#define GPIOJ_PIN4                     4U
#define GPIOJ_PIN5                     5U
#define GPIOJ_PIN6                     6U
#define GPIOJ_PIN7                     7U
#define GPIOJ_PIN8                     8U
#define GPIOJ_PIN9                     9U
#define GPIOJ_PIN10                    10U
#define GPIOJ_PIN11                    11U
#define GPIOJ_PIN12                    12U
#define GPIOJ_PIN13                    13U
#define GPIOJ_PIN14                    14U
#define GPIOJ_PIN15                    15U

#define GPIOK_PIN0                     0U
#define GPIOK_PIN1                     1U
#define GPIOK_PIN2                     2U
#define GPIOK_PIN3                     3U
#define GPIOK_PIN4                     4U
#define GPIOK_PIN5                     5U
#define GPIOK_PIN6                     6U
#define GPIOK_PIN7                     7U
#define GPIOK_PIN8                     8U
#define GPIOK_PIN9                     9U
#define GPIOK_PIN10                    10U
#define GPIOK_PIN11                    11U
#define GPIOK_PIN12                    12U
#define GPIOK_PIN13                    13U
#define GPIOK_PIN14                    14U
#define GPIOK_PIN15                    15U

/*
    IO lines assignments.
*/

#define LINE_BATT_CE                   PAL_LINE(GPIOB, 14U)
#define LINE_BATT_CHG                  PAL_LINE(GPIOB, 12U)
#define LINE_BATT_I_CHG                PAL_LINE(GPIOF, 3U)
#define LINE_BATT_PGOOD                PAL_LINE(GPIOB, 13U)
#define LINE_BATT_V_MON                PAL_LINE(GPIOF, 4U)
#define LINE_CS2100_CLK                PAL_LINE(GPIOH, 0U)
#define LINE_CS2100_SCL                PAL_LINE(GPIOA, 8U)
#define LINE_CS2100_SDA                PAL_LINE(GPIOC, 9U)
#define LINE_EEPROM_CS                 PAL_LINE(GPIOF, 10U)
#define LINE_GPS_PPS                   PAL_LINE(GPIOB, 3U)
#define LINE_GPS_RESET                 PAL_LINE(GPIOD, 4U)
#define LINE_GPS_RXD                   PAL_LINE(GPIOD, 5U)
#define LINE_GPS_TXD                   PAL_LINE(GPIOD, 6U)
#define LINE_LCD_B2                    PAL_LINE(GPIOG, 10U)
#define LINE_LCD_B3                    PAL_LINE(GPIOD, 10U)
#define LINE_LCD_B4                    PAL_LINE(GPIOE, 12U)
#define LINE_LCD_B5                    PAL_LINE(GPIOA, 3U)
#define LINE_LCD_B6                    PAL_LINE(GPIOB, 8U)
#define LINE_LCD_B7                    PAL_LINE(GPIOB, 9U)
#define LINE_LCD_BACKLIGHT             PAL_LINE(GPIOD, 12U)
#define LINE_LCD_CS                    PAL_LINE(GPIOE, 4U)
#define LINE_LCD_DCX                   PAL_LINE(GPIOE, 3U)
#define LINE_LCD_DE                    PAL_LINE(GPIOE, 13U)
#define LINE_LCD_DOTCLK                PAL_LINE(GPIOE, 14U)
#define LINE_LCD_G2                    PAL_LINE(GPIOA, 6U)
#define LINE_LCD_G3                    PAL_LINE(GPIOE, 11U)
#define LINE_LCD_G4                    PAL_LINE(GPIOB, 10U)
#define LINE_LCD_G5                    PAL_LINE(GPIOB, 11U)
#define LINE_LCD_G6                    PAL_LINE(GPIOC, 7U)
#define LINE_LCD_G7                    PAL_LINE(GPIOG, 8U)
#define LINE_LCD_HSYNC                 PAL_LINE(GPIOC, 6U)
#define LINE_LCD_R2                    PAL_LINE(GPIOC, 10U)
#define LINE_LCD_R3                    PAL_LINE(GPIOB, 0U)
#define LINE_LCD_R4                    PAL_LINE(GPIOA, 11U)
#define LINE_LCD_R5                    PAL_LINE(GPIOA, 12U)
#define LINE_LCD_R6                    PAL_LINE(GPIOB, 1U)
#define LINE_LCD_R7                    PAL_LINE(GPIOE, 15U)
#define LINE_LCD_RST                   PAL_LINE(GPIOE, 5U)
#define LINE_LCD_SCL                   PAL_LINE(GPIOE, 2U)
#define LINE_LCD_SDA                   PAL_LINE(GPIOE, 6U)
#define LINE_LCD_VSYNC                 PAL_LINE(GPIOA, 4U)
#define LINE_LED_GRN                   PAL_LINE(GPIOB, 7U)
#define LINE_LED_RED                   PAL_LINE(GPIOB, 5U)
#define LINE_LED_YLW                   PAL_LINE(GPIOB, 6U)
#define LINE_MAINS_BIAS                PAL_LINE(GPIOC, 3U)
#define LINE_MAINS_WAVE                PAL_LINE(GPIOC, 2U)
#define LINE_MAINS_ZC                  PAL_LINE(GPIOA, 15U)
#define LINE_PHY_RST                   PAL_LINE(GPIOB, 15U)
#define LINE_RMII_CRS_DV               PAL_LINE(GPIOA, 7U)
#define LINE_RMII_MDC                  PAL_LINE(GPIOC, 1U)
#define LINE_RMII_MDIO                 PAL_LINE(GPIOA, 2U)
#define LINE_RMII_REF_CLK              PAL_LINE(GPIOA, 1U)
#define LINE_RMII_RXD0                 PAL_LINE(GPIOC, 4U)
#define LINE_RMII_RXD1                 PAL_LINE(GPIOC, 5U)
#define LINE_RMII_TXD0                 PAL_LINE(GPIOG, 13U)
#define LINE_RMII_TXD1                 PAL_LINE(GPIOG, 14U)
#define LINE_RMII_TX_EN                PAL_LINE(GPIOG, 11U)
#define LINE_SOUNDER                   PAL_LINE(GPIOA, 5U)
#define LINE_SOUNDER_SD                PAL_LINE(GPIOB, 2U)
#define LINE_SWCLK                     PAL_LINE(GPIOA, 14U)
#define LINE_SWDIO                     PAL_LINE(GPIOA, 13U)
#define LINE_TOUCH_CS                  PAL_LINE(GPIOF, 6U)
#define LINE_TOUCH_INT                 PAL_LINE(GPIOF, 5U)
#define LINE_TOUCH_SCK                 PAL_LINE(GPIOF, 7U)
#define LINE_TOUCH_SDI                 PAL_LINE(GPIOF, 9U)
#define LINE_TOUCH_SDO                 PAL_LINE(GPIOF, 8U)
#define LINE_USD_CLK                   PAL_LINE(GPIOC, 12U)
#define LINE_USD_CMD                   PAL_LINE(GPIOD, 2U)
#define LINE_USD_DAT0                  PAL_LINE(GPIOC, 8U)

/*
    I/O ports initial setup, this configuration is established soon after reset
    in the initialization code.
     Please refer to the STM32 Reference Manual for details.
*/
#define PIN_MODE_INPUT(n)              (0U << ((n) * 2U))
#define PIN_MODE_OUTPUT(n)             (1U << ((n) * 2U))
#define PIN_MODE_ALTERNATE(n)          (2U << ((n) * 2U))
#define PIN_MODE_ANALOG(n)             (3U << ((n) * 2U))
#define PIN_OD_LOW(n)                  (0U << (n))
#define PIN_OD_HIGH(n)                 (1U << (n))
#define PIN_OTYPE_PUSHPULL(n)          (0U << (n))
#define PIN_OTYPE_OPENDRAIN(n)         (1U << (n))
#define PIN_OSPEED_VERYLOW(n)          (0U << ((n) * 2U))
#define PIN_OSPEED_LOW(n)              (1U << ((n) * 2U))
#define PIN_OSPEED_MEDIUM(n)           (2U << ((n) * 2U))
#define PIN_OSPEED_HIGH(n)             (3U << ((n) * 2U))
#define PIN_PUPD_FLOATING(n)           (0U << ((n) * 2U))
#define PIN_PUPD_PULLUP(n)             (1U << ((n) * 2U))
#define PIN_PUPD_PULLDOWN(n)           (2U << ((n) * 2U))
#define PIN_AFIO_AF(n, v)              ((v) << (((n) % 8U) * 4U))

/*
 *  GPIOA setup:
 *
 * PA0  - PIN0                         (unused).
 * PA1  - RMII_REF_CLK                 (af11).
 * PA2  - RMII_MDIO                    (af11).
 * PA3  - LCD_B5                       (af14).
 * PA4  - LCD_VSYNC                    (af14).
 * PA5  - SOUNDER                      (analog).
 * PA6  - LCD_G2                       (af14).
 * PA7  - RMII_CRS_DV                  (af11).
 * PA8  - CS2100_SCL                   (af4).
 * PA9  - PIN9                         (unused).
 * PA10 - PIN10                        (unused).
 * PA11 - LCD_R4                       (af14).
 * PA12 - LCD_R5                       (af14).
 * PA13 - SWDIO                        (af0, pulldown).
 * PA14 - SWCLK                        (af0, pulldown).
 * PA15 - MAINS_ZC                     (af1).
*/
#define VAL_GPIOA_MODER                (PIN_MODE_INPUT(GPIOA_PIN0) | \
                                        PIN_MODE_ALTERNATE(GPIOA_RMII_REF_CLK) | \
                                        PIN_MODE_ALTERNATE(GPIOA_RMII_MDIO) | \
                                        PIN_MODE_ALTERNATE(GPIOA_LCD_B5) | \
                                        PIN_MODE_ALTERNATE(GPIOA_LCD_VSYNC) | \
                                        PIN_MODE_ANALOG(GPIOA_SOUNDER) | \
                                        PIN_MODE_ALTERNATE(GPIOA_LCD_G2) | \
                                        PIN_MODE_ALTERNATE(GPIOA_RMII_CRS_DV) | \
                                        PIN_MODE_ALTERNATE(GPIOA_CS2100_SCL) | \
                                        PIN_MODE_INPUT(GPIOA_PIN9) | \
                                        PIN_MODE_INPUT(GPIOA_PIN10) | \
                                        PIN_MODE_ALTERNATE(GPIOA_LCD_R4) | \
                                        PIN_MODE_ALTERNATE(GPIOA_LCD_R5) | \
                                        PIN_MODE_ALTERNATE(GPIOA_SWDIO) | \
                                        PIN_MODE_ALTERNATE(GPIOA_SWCLK) | \
                                        PIN_MODE_ALTERNATE(GPIOA_MAINS_ZC))
#define VAL_GPIOA_OTYPER               (PIN_OTYPE_PUSHPULL(GPIOA_PIN0) | \
                                        PIN_OTYPE_PUSHPULL(GPIOA_RMII_REF_CLK) | \
                                        PIN_OTYPE_PUSHPULL(GPIOA_RMII_MDIO) | \
                                        PIN_OTYPE_PUSHPULL(GPIOA_LCD_B5) | \
                                        PIN_OTYPE_PUSHPULL(GPIOA_LCD_VSYNC) | \
                                        PIN_OTYPE_PUSHPULL(GPIOA_SOUNDER) | \
                                        PIN_OTYPE_PUSHPULL(GPIOA_LCD_G2) | \
                                        PIN_OTYPE_PUSHPULL(GPIOA_RMII_CRS_DV) | \
                                        PIN_OTYPE_OPENDRAIN(GPIOA_CS2100_SCL) | \
                                        PIN_OTYPE_PUSHPULL(GPIOA_PIN9) | \
                                        PIN_OTYPE_PUSHPULL(GPIOA_PIN10) | \
                                        PIN_OTYPE_PUSHPULL(GPIOA_LCD_R4) | \
                                        PIN_OTYPE_PUSHPULL(GPIOA_LCD_R5) | \
                                        PIN_OTYPE_PUSHPULL(GPIOA_SWDIO) | \
                                        PIN_OTYPE_PUSHPULL(GPIOA_SWCLK) | \
                                        PIN_OTYPE_PUSHPULL(GPIOA_MAINS_ZC))
#define VAL_GPIOA_OSPEEDR              (PIN_OSPEED_HIGH(GPIOA_PIN0) | \
                                        PIN_OSPEED_HIGH(GPIOA_RMII_REF_CLK) | \
                                        PIN_OSPEED_HIGH(GPIOA_RMII_MDIO) | \
                                        PIN_OSPEED_HIGH(GPIOA_LCD_B5) | \
                                        PIN_OSPEED_HIGH(GPIOA_LCD_VSYNC) | \
                                        PIN_OSPEED_HIGH(GPIOA_SOUNDER) | \
                                        PIN_OSPEED_HIGH(GPIOA_LCD_G2) | \
                                        PIN_OSPEED_HIGH(GPIOA_RMII_CRS_DV) | \
                                        PIN_OSPEED_HIGH(GPIOA_CS2100_SCL) | \
                                        PIN_OSPEED_HIGH(GPIOA_PIN9) | \
                                        PIN_OSPEED_HIGH(GPIOA_PIN10) | \
                                        PIN_OSPEED_HIGH(GPIOA_LCD_R4) | \
                                        PIN_OSPEED_HIGH(GPIOA_LCD_R5) | \
                                        PIN_OSPEED_HIGH(GPIOA_SWDIO) | \
                                        PIN_OSPEED_HIGH(GPIOA_SWCLK) | \
                                        PIN_OSPEED_HIGH(GPIOA_MAINS_ZC))
#define VAL_GPIOA_PUPDR                (PIN_PUPD_PULLUP(GPIOA_PIN0) | \
                                        PIN_PUPD_FLOATING(GPIOA_RMII_REF_CLK) | \
                                        PIN_PUPD_PULLUP(GPIOA_RMII_MDIO) | \
                                        PIN_PUPD_PULLUP(GPIOA_LCD_B5) | \
                                        PIN_PUPD_PULLUP(GPIOA_LCD_VSYNC) | \
                                        PIN_PUPD_PULLUP(GPIOA_SOUNDER) | \
                                        PIN_PUPD_PULLUP(GPIOA_LCD_G2) | \
                                        PIN_PUPD_PULLUP(GPIOA_RMII_CRS_DV) | \
                                        PIN_PUPD_PULLUP(GPIOA_CS2100_SCL) | \
                                        PIN_PUPD_PULLUP(GPIOA_PIN9) | \
                                        PIN_PUPD_PULLUP(GPIOA_PIN10) | \
                                        PIN_PUPD_PULLUP(GPIOA_LCD_R4) | \
                                        PIN_PUPD_PULLUP(GPIOA_LCD_R5) | \
                                        PIN_PUPD_PULLDOWN(GPIOA_SWDIO) | \
                                        PIN_PUPD_PULLDOWN(GPIOA_SWCLK) | \
                                        PIN_PUPD_FLOATING(GPIOA_MAINS_ZC))
#define VAL_GPIOA_ODR                  (PIN_OD_HIGH(GPIOA_PIN0) | \
                                        PIN_OD_HIGH(GPIOA_RMII_REF_CLK) | \
                                        PIN_OD_HIGH(GPIOA_RMII_MDIO) | \
                                        PIN_OD_HIGH(GPIOA_LCD_B5) | \
                                        PIN_OD_HIGH(GPIOA_LCD_VSYNC) | \
                                        PIN_OD_HIGH(GPIOA_SOUNDER) | \
                                        PIN_OD_HIGH(GPIOA_LCD_G2) | \
                                        PIN_OD_HIGH(GPIOA_RMII_CRS_DV) | \
                                        PIN_OD_HIGH(GPIOA_CS2100_SCL) | \
                                        PIN_OD_HIGH(GPIOA_PIN9) | \
                                        PIN_OD_HIGH(GPIOA_PIN10) | \
                                        PIN_OD_HIGH(GPIOA_LCD_R4) | \
                                        PIN_OD_HIGH(GPIOA_LCD_R5) | \
                                        PIN_OD_HIGH(GPIOA_SWDIO) | \
                                        PIN_OD_HIGH(GPIOA_SWCLK) | \
                                        PIN_OD_HIGH(GPIOA_MAINS_ZC))
#define VAL_GPIOA_AFRL                 (PIN_AFIO_AF(GPIOA_PIN0, 0U) | \
                                        PIN_AFIO_AF(GPIOA_RMII_REF_CLK, 11U) | \
                                        PIN_AFIO_AF(GPIOA_RMII_MDIO, 11U) | \
                                        PIN_AFIO_AF(GPIOA_LCD_B5, 14U) | \
                                        PIN_AFIO_AF(GPIOA_LCD_VSYNC, 14U) | \
                                        PIN_AFIO_AF(GPIOA_SOUNDER, 0U) | \
                                        PIN_AFIO_AF(GPIOA_LCD_G2, 14U) | \
                                        PIN_AFIO_AF(GPIOA_RMII_CRS_DV, 11U))
#define VAL_GPIOA_AFRH                 (PIN_AFIO_AF(GPIOA_CS2100_SCL, 4U) | \
                                        PIN_AFIO_AF(GPIOA_PIN9, 0U) | \
                                        PIN_AFIO_AF(GPIOA_PIN10, 0U) | \
                                        PIN_AFIO_AF(GPIOA_LCD_R4, 14U) | \
                                        PIN_AFIO_AF(GPIOA_LCD_R5, 14U) | \
                                        PIN_AFIO_AF(GPIOA_SWDIO, 0U) | \
                                        PIN_AFIO_AF(GPIOA_SWCLK, 0U) | \
                                        PIN_AFIO_AF(GPIOA_MAINS_ZC, 1U))

/*
 *  GPIOB setup:
 *
 * PB0  - LCD_R3                       (af9).
 * PB1  - LCD_R6                       (af9).
 * PB2  - SOUNDER_SD                   (output, startlow).
 * PB3  - GPS_PPS                      (floating, af1).
 * PB4  - PIN4                         (unused).
 * PB5  - LED_RED                      (output, startlow).
 * PB6  - LED_YLW                      (output, startlow).
 * PB7  - LED_GRN                      (output, startlow).
 * PB8  - LCD_B6                       (af14).
 * PB9  - LCD_B7                       (af14).
 * PB10 - LCD_G4                       (af14).
 * PB11 - LCD_G5                       (af14).
 * PB12 - BATT_CHG                     ().
 * PB13 - BATT_PGOOD                   ().
 * PB14 - BATT_CE                      (output).
 * PB15 - PHY_RST                      (output, floating, startlow).
*/
#define VAL_GPIOB_MODER                (PIN_MODE_ALTERNATE(GPIOB_LCD_R3) | \
                                        PIN_MODE_ALTERNATE(GPIOB_LCD_R6) | \
                                        PIN_MODE_OUTPUT(GPIOB_SOUNDER_SD) | \
                                        PIN_MODE_ALTERNATE(GPIOB_GPS_PPS) | \
                                        PIN_MODE_INPUT(GPIOB_PIN4) | \
                                        PIN_MODE_OUTPUT(GPIOB_LED_RED) | \
                                        PIN_MODE_OUTPUT(GPIOB_LED_YLW) | \
                                        PIN_MODE_OUTPUT(GPIOB_LED_GRN) | \
                                        PIN_MODE_ALTERNATE(GPIOB_LCD_B6) | \
                                        PIN_MODE_ALTERNATE(GPIOB_LCD_B7) | \
                                        PIN_MODE_ALTERNATE(GPIOB_LCD_G4) | \
                                        PIN_MODE_ALTERNATE(GPIOB_LCD_G5) | \
                                        PIN_MODE_INPUT(GPIOB_BATT_CHG) | \
                                        PIN_MODE_INPUT(GPIOB_BATT_PGOOD) | \
                                        PIN_MODE_OUTPUT(GPIOB_BATT_CE) | \
                                        PIN_MODE_OUTPUT(GPIOB_PHY_RST))
#define VAL_GPIOB_OTYPER               (PIN_OTYPE_PUSHPULL(GPIOB_LCD_R3) | \
                                        PIN_OTYPE_PUSHPULL(GPIOB_LCD_R6) | \
                                        PIN_OTYPE_PUSHPULL(GPIOB_SOUNDER_SD) | \
                                        PIN_OTYPE_PUSHPULL(GPIOB_GPS_PPS) | \
                                        PIN_OTYPE_PUSHPULL(GPIOB_PIN4) | \
                                        PIN_OTYPE_PUSHPULL(GPIOB_LED_RED) | \
                                        PIN_OTYPE_PUSHPULL(GPIOB_LED_YLW) | \
                                        PIN_OTYPE_PUSHPULL(GPIOB_LED_GRN) | \
                                        PIN_OTYPE_PUSHPULL(GPIOB_LCD_B6) | \
                                        PIN_OTYPE_PUSHPULL(GPIOB_LCD_B7) | \
                                        PIN_OTYPE_PUSHPULL(GPIOB_LCD_G4) | \
                                        PIN_OTYPE_PUSHPULL(GPIOB_LCD_G5) | \
                                        PIN_OTYPE_PUSHPULL(GPIOB_BATT_CHG) | \
                                        PIN_OTYPE_PUSHPULL(GPIOB_BATT_PGOOD) | \
                                        PIN_OTYPE_PUSHPULL(GPIOB_BATT_CE) | \
                                        PIN_OTYPE_PUSHPULL(GPIOB_PHY_RST))
#define VAL_GPIOB_OSPEEDR              (PIN_OSPEED_HIGH(GPIOB_LCD_R3) | \
                                        PIN_OSPEED_HIGH(GPIOB_LCD_R6) | \
                                        PIN_OSPEED_HIGH(GPIOB_SOUNDER_SD) | \
                                        PIN_OSPEED_HIGH(GPIOB_GPS_PPS) | \
                                        PIN_OSPEED_HIGH(GPIOB_PIN4) | \
                                        PIN_OSPEED_HIGH(GPIOB_LED_RED) | \
                                        PIN_OSPEED_HIGH(GPIOB_LED_YLW) | \
                                        PIN_OSPEED_HIGH(GPIOB_LED_GRN) | \
                                        PIN_OSPEED_HIGH(GPIOB_LCD_B6) | \
                                        PIN_OSPEED_HIGH(GPIOB_LCD_B7) | \
                                        PIN_OSPEED_HIGH(GPIOB_LCD_G4) | \
                                        PIN_OSPEED_HIGH(GPIOB_LCD_G5) | \
                                        PIN_OSPEED_HIGH(GPIOB_BATT_CHG) | \
                                        PIN_OSPEED_HIGH(GPIOB_BATT_PGOOD) | \
                                        PIN_OSPEED_HIGH(GPIOB_BATT_CE) | \
                                        PIN_OSPEED_HIGH(GPIOB_PHY_RST))
#define VAL_GPIOB_PUPDR                (PIN_PUPD_PULLUP(GPIOB_LCD_R3) | \
                                        PIN_PUPD_PULLUP(GPIOB_LCD_R6) | \
                                        PIN_PUPD_PULLUP(GPIOB_SOUNDER_SD) | \
                                        PIN_PUPD_FLOATING(GPIOB_GPS_PPS) | \
                                        PIN_PUPD_PULLUP(GPIOB_PIN4) | \
                                        PIN_PUPD_PULLUP(GPIOB_LED_RED) | \
                                        PIN_PUPD_PULLUP(GPIOB_LED_YLW) | \
                                        PIN_PUPD_PULLUP(GPIOB_LED_GRN) | \
                                        PIN_PUPD_PULLUP(GPIOB_LCD_B6) | \
                                        PIN_PUPD_PULLUP(GPIOB_LCD_B7) | \
                                        PIN_PUPD_PULLUP(GPIOB_LCD_G4) | \
                                        PIN_PUPD_PULLUP(GPIOB_LCD_G5) | \
                                        PIN_PUPD_PULLUP(GPIOB_BATT_CHG) | \
                                        PIN_PUPD_PULLUP(GPIOB_BATT_PGOOD) | \
                                        PIN_PUPD_PULLUP(GPIOB_BATT_CE) | \
                                        PIN_PUPD_FLOATING(GPIOB_PHY_RST))
#define VAL_GPIOB_ODR                  (PIN_OD_HIGH(GPIOB_LCD_R3) | \
                                        PIN_OD_HIGH(GPIOB_LCD_R6) | \
                                        PIN_OD_LOW(GPIOB_SOUNDER_SD) | \
                                        PIN_OD_HIGH(GPIOB_GPS_PPS) | \
                                        PIN_OD_HIGH(GPIOB_PIN4) | \
                                        PIN_OD_LOW(GPIOB_LED_RED) | \
                                        PIN_OD_LOW(GPIOB_LED_YLW) | \
                                        PIN_OD_LOW(GPIOB_LED_GRN) | \
                                        PIN_OD_HIGH(GPIOB_LCD_B6) | \
                                        PIN_OD_HIGH(GPIOB_LCD_B7) | \
                                        PIN_OD_HIGH(GPIOB_LCD_G4) | \
                                        PIN_OD_HIGH(GPIOB_LCD_G5) | \
                                        PIN_OD_HIGH(GPIOB_BATT_CHG) | \
                                        PIN_OD_HIGH(GPIOB_BATT_PGOOD) | \
                                        PIN_OD_HIGH(GPIOB_BATT_CE) | \
                                        PIN_OD_LOW(GPIOB_PHY_RST))
#define VAL_GPIOB_AFRL                 (PIN_AFIO_AF(GPIOB_LCD_R3, 9U) | \
                                        PIN_AFIO_AF(GPIOB_LCD_R6, 9U) | \
                                        PIN_AFIO_AF(GPIOB_SOUNDER_SD, 0U) | \
                                        PIN_AFIO_AF(GPIOB_GPS_PPS, 1U) | \
                                        PIN_AFIO_AF(GPIOB_PIN4, 0U) | \
                                        PIN_AFIO_AF(GPIOB_LED_RED, 0U) | \
                                        PIN_AFIO_AF(GPIOB_LED_YLW, 0U) | \
                                        PIN_AFIO_AF(GPIOB_LED_GRN, 0U))
#define VAL_GPIOB_AFRH                 (PIN_AFIO_AF(GPIOB_LCD_B6, 14U) | \
                                        PIN_AFIO_AF(GPIOB_LCD_B7, 14U) | \
                                        PIN_AFIO_AF(GPIOB_LCD_G4, 14U) | \
                                        PIN_AFIO_AF(GPIOB_LCD_G5, 14U) | \
                                        PIN_AFIO_AF(GPIOB_BATT_CHG, 0U) | \
                                        PIN_AFIO_AF(GPIOB_BATT_PGOOD, 0U) | \
                                        PIN_AFIO_AF(GPIOB_BATT_CE, 0U) | \
                                        PIN_AFIO_AF(GPIOB_PHY_RST, 0U))

/*
 *  GPIOC setup:
 *
 * PC0  - PIN0                         (unused).
 * PC1  - RMII_MDC                     (af11).
 * PC2  - MAINS_WAVE                   (floating, analog).
 * PC3  - MAINS_BIAS                   (floating, analog).
 * PC4  - RMII_RXD0                    (af11).
 * PC5  - RMII_RXD1                    (af11).
 * PC6  - LCD_HSYNC                    (af14).
 * PC7  - LCD_G6                       (af14).
 * PC8  - USD_DAT0                     (af12).
 * PC9  - CS2100_SDA                   (af4).
 * PC10 - LCD_R2                       (af14).
 * PC11 - PIN11                        (unused).
 * PC12 - USD_CLK                      (af12).
 * PC13 - PIN13                        (unused).
 * PC14 - PIN14                        (unused).
 * PC15 - PIN15                        (unused).
*/
#define VAL_GPIOC_MODER                (PIN_MODE_INPUT(GPIOC_PIN0) | \
                                        PIN_MODE_ALTERNATE(GPIOC_RMII_MDC) | \
                                        PIN_MODE_ANALOG(GPIOC_MAINS_WAVE) | \
                                        PIN_MODE_ANALOG(GPIOC_MAINS_BIAS) | \
                                        PIN_MODE_ALTERNATE(GPIOC_RMII_RXD0) | \
                                        PIN_MODE_ALTERNATE(GPIOC_RMII_RXD1) | \
                                        PIN_MODE_ALTERNATE(GPIOC_LCD_HSYNC) | \
                                        PIN_MODE_ALTERNATE(GPIOC_LCD_G6) | \
                                        PIN_MODE_ALTERNATE(GPIOC_USD_DAT0) | \
                                        PIN_MODE_ALTERNATE(GPIOC_CS2100_SDA) | \
                                        PIN_MODE_ALTERNATE(GPIOC_LCD_R2) | \
                                        PIN_MODE_INPUT(GPIOC_PIN11) | \
                                        PIN_MODE_ALTERNATE(GPIOC_USD_CLK) | \
                                        PIN_MODE_INPUT(GPIOC_PIN13) | \
                                        PIN_MODE_INPUT(GPIOC_PIN14) | \
                                        PIN_MODE_INPUT(GPIOC_PIN15))
#define VAL_GPIOC_OTYPER               (PIN_OTYPE_PUSHPULL(GPIOC_PIN0) | \
                                        PIN_OTYPE_PUSHPULL(GPIOC_RMII_MDC) | \
                                        PIN_OTYPE_PUSHPULL(GPIOC_MAINS_WAVE) | \
                                        PIN_OTYPE_PUSHPULL(GPIOC_MAINS_BIAS) | \
                                        PIN_OTYPE_PUSHPULL(GPIOC_RMII_RXD0) | \
                                        PIN_OTYPE_PUSHPULL(GPIOC_RMII_RXD1) | \
                                        PIN_OTYPE_PUSHPULL(GPIOC_LCD_HSYNC) | \
                                        PIN_OTYPE_PUSHPULL(GPIOC_LCD_G6) | \
                                        PIN_OTYPE_PUSHPULL(GPIOC_USD_DAT0) | \
                                        PIN_OTYPE_OPENDRAIN(GPIOC_CS2100_SDA) | \
                                        PIN_OTYPE_PUSHPULL(GPIOC_LCD_R2) | \
                                        PIN_OTYPE_PUSHPULL(GPIOC_PIN11) | \
                                        PIN_OTYPE_PUSHPULL(GPIOC_USD_CLK) | \
                                        PIN_OTYPE_PUSHPULL(GPIOC_PIN13) | \
                                        PIN_OTYPE_PUSHPULL(GPIOC_PIN14) | \
                                        PIN_OTYPE_PUSHPULL(GPIOC_PIN15))
#define VAL_GPIOC_OSPEEDR              (PIN_OSPEED_HIGH(GPIOC_PIN0) | \
                                        PIN_OSPEED_HIGH(GPIOC_RMII_MDC) | \
                                        PIN_OSPEED_HIGH(GPIOC_MAINS_WAVE) | \
                                        PIN_OSPEED_HIGH(GPIOC_MAINS_BIAS) | \
                                        PIN_OSPEED_HIGH(GPIOC_RMII_RXD0) | \
                                        PIN_OSPEED_HIGH(GPIOC_RMII_RXD1) | \
                                        PIN_OSPEED_HIGH(GPIOC_LCD_HSYNC) | \
                                        PIN_OSPEED_HIGH(GPIOC_LCD_G6) | \
                                        PIN_OSPEED_HIGH(GPIOC_USD_DAT0) | \
                                        PIN_OSPEED_HIGH(GPIOC_CS2100_SDA) | \
                                        PIN_OSPEED_HIGH(GPIOC_LCD_R2) | \
                                        PIN_OSPEED_HIGH(GPIOC_PIN11) | \
                                        PIN_OSPEED_HIGH(GPIOC_USD_CLK) | \
                                        PIN_OSPEED_HIGH(GPIOC_PIN13) | \
                                        PIN_OSPEED_HIGH(GPIOC_PIN14) | \
                                        PIN_OSPEED_HIGH(GPIOC_PIN15))
#define VAL_GPIOC_PUPDR                (PIN_PUPD_PULLUP(GPIOC_PIN0) | \
                                        PIN_PUPD_FLOATING(GPIOC_RMII_MDC) | \
                                        PIN_PUPD_FLOATING(GPIOC_MAINS_WAVE) | \
                                        PIN_PUPD_FLOATING(GPIOC_MAINS_BIAS) | \
                                        PIN_PUPD_FLOATING(GPIOC_RMII_RXD0) | \
                                        PIN_PUPD_FLOATING(GPIOC_RMII_RXD1) | \
                                        PIN_PUPD_PULLUP(GPIOC_LCD_HSYNC) | \
                                        PIN_PUPD_PULLUP(GPIOC_LCD_G6) | \
                                        PIN_PUPD_PULLUP(GPIOC_USD_DAT0) | \
                                        PIN_PUPD_PULLUP(GPIOC_CS2100_SDA) | \
                                        PIN_PUPD_PULLUP(GPIOC_LCD_R2) | \
                                        PIN_PUPD_PULLUP(GPIOC_PIN11) | \
                                        PIN_PUPD_PULLUP(GPIOC_USD_CLK) | \
                                        PIN_PUPD_PULLUP(GPIOC_PIN13) | \
                                        PIN_PUPD_PULLUP(GPIOC_PIN14) | \
                                        PIN_PUPD_PULLUP(GPIOC_PIN15))
#define VAL_GPIOC_ODR                  (PIN_OD_HIGH(GPIOC_PIN0) | \
                                        PIN_OD_HIGH(GPIOC_RMII_MDC) | \
                                        PIN_OD_HIGH(GPIOC_MAINS_WAVE) | \
                                        PIN_OD_HIGH(GPIOC_MAINS_BIAS) | \
                                        PIN_OD_HIGH(GPIOC_RMII_RXD0) | \
                                        PIN_OD_HIGH(GPIOC_RMII_RXD1) | \
                                        PIN_OD_HIGH(GPIOC_LCD_HSYNC) | \
                                        PIN_OD_HIGH(GPIOC_LCD_G6) | \
                                        PIN_OD_HIGH(GPIOC_USD_DAT0) | \
                                        PIN_OD_HIGH(GPIOC_CS2100_SDA) | \
                                        PIN_OD_HIGH(GPIOC_LCD_R2) | \
                                        PIN_OD_HIGH(GPIOC_PIN11) | \
                                        PIN_OD_HIGH(GPIOC_USD_CLK) | \
                                        PIN_OD_HIGH(GPIOC_PIN13) | \
                                        PIN_OD_HIGH(GPIOC_PIN14) | \
                                        PIN_OD_HIGH(GPIOC_PIN15))
#define VAL_GPIOC_AFRL                 (PIN_AFIO_AF(GPIOC_PIN0, 0U) | \
                                        PIN_AFIO_AF(GPIOC_RMII_MDC, 11U) | \
                                        PIN_AFIO_AF(GPIOC_MAINS_WAVE, 0U) | \
                                        PIN_AFIO_AF(GPIOC_MAINS_BIAS, 0U) | \
                                        PIN_AFIO_AF(GPIOC_RMII_RXD0, 11U) | \
                                        PIN_AFIO_AF(GPIOC_RMII_RXD1, 11U) | \
                                        PIN_AFIO_AF(GPIOC_LCD_HSYNC, 14U) | \
                                        PIN_AFIO_AF(GPIOC_LCD_G6, 14U))
#define VAL_GPIOC_AFRH                 (PIN_AFIO_AF(GPIOC_USD_DAT0, 12U) | \
                                        PIN_AFIO_AF(GPIOC_CS2100_SDA, 4U) | \
                                        PIN_AFIO_AF(GPIOC_LCD_R2, 14U) | \
                                        PIN_AFIO_AF(GPIOC_PIN11, 0U) | \
                                        PIN_AFIO_AF(GPIOC_USD_CLK, 12U) | \
                                        PIN_AFIO_AF(GPIOC_PIN13, 0U) | \
                                        PIN_AFIO_AF(GPIOC_PIN14, 0U) | \
                                        PIN_AFIO_AF(GPIOC_PIN15, 0U))

/*
 *  GPIOD setup:
 *
 * PD0  - PIN0                         (unused).
 * PD1  - PIN1                         (unused).
 * PD2  - USD_CMD                      (af12).
 * PD3  - PIN3                         (unused).
 * PD4  - GPS_RESET                    (output).
 * PD5  - GPS_RXD                      (af7).
 * PD6  - GPS_TXD                      (af7).
 * PD7  - PIN7                         (unused).
 * PD8  - PIN8                         (unused).
 * PD9  - PIN9                         (unused).
 * PD10 - LCD_B3                       (af14).
 * PD11 - PIN11                        (unused).
 * PD12 - LCD_BACKLIGHT                (af2).
 * PD13 - PIN13                        (unused).
 * PD14 - PIN14                        (unused).
 * PD15 - PIN15                        (unused).
*/
#define VAL_GPIOD_MODER                (PIN_MODE_INPUT(GPIOD_PIN0) | \
                                        PIN_MODE_INPUT(GPIOD_PIN1) | \
                                        PIN_MODE_ALTERNATE(GPIOD_USD_CMD) | \
                                        PIN_MODE_INPUT(GPIOD_PIN3) | \
                                        PIN_MODE_OUTPUT(GPIOD_GPS_RESET) | \
                                        PIN_MODE_ALTERNATE(GPIOD_GPS_RXD) | \
                                        PIN_MODE_ALTERNATE(GPIOD_GPS_TXD) | \
                                        PIN_MODE_INPUT(GPIOD_PIN7) | \
                                        PIN_MODE_INPUT(GPIOD_PIN8) | \
                                        PIN_MODE_INPUT(GPIOD_PIN9) | \
                                        PIN_MODE_ALTERNATE(GPIOD_LCD_B3) | \
                                        PIN_MODE_INPUT(GPIOD_PIN11) | \
                                        PIN_MODE_ALTERNATE(GPIOD_LCD_BACKLIGHT) | \
                                        PIN_MODE_INPUT(GPIOD_PIN13) | \
                                        PIN_MODE_INPUT(GPIOD_PIN14) | \
                                        PIN_MODE_INPUT(GPIOD_PIN15))
#define VAL_GPIOD_OTYPER               (PIN_OTYPE_PUSHPULL(GPIOD_PIN0) | \
                                        PIN_OTYPE_PUSHPULL(GPIOD_PIN1) | \
                                        PIN_OTYPE_PUSHPULL(GPIOD_USD_CMD) | \
                                        PIN_OTYPE_PUSHPULL(GPIOD_PIN3) | \
                                        PIN_OTYPE_PUSHPULL(GPIOD_GPS_RESET) | \
                                        PIN_OTYPE_PUSHPULL(GPIOD_GPS_RXD) | \
                                        PIN_OTYPE_PUSHPULL(GPIOD_GPS_TXD) | \
                                        PIN_OTYPE_PUSHPULL(GPIOD_PIN7) | \
                                        PIN_OTYPE_PUSHPULL(GPIOD_PIN8) | \
                                        PIN_OTYPE_PUSHPULL(GPIOD_PIN9) | \
                                        PIN_OTYPE_PUSHPULL(GPIOD_LCD_B3) | \
                                        PIN_OTYPE_PUSHPULL(GPIOD_PIN11) | \
                                        PIN_OTYPE_PUSHPULL(GPIOD_LCD_BACKLIGHT) | \
                                        PIN_OTYPE_PUSHPULL(GPIOD_PIN13) | \
                                        PIN_OTYPE_PUSHPULL(GPIOD_PIN14) | \
                                        PIN_OTYPE_PUSHPULL(GPIOD_PIN15))
#define VAL_GPIOD_OSPEEDR              (PIN_OSPEED_HIGH(GPIOD_PIN0) | \
                                        PIN_OSPEED_HIGH(GPIOD_PIN1) | \
                                        PIN_OSPEED_HIGH(GPIOD_USD_CMD) | \
                                        PIN_OSPEED_HIGH(GPIOD_PIN3) | \
                                        PIN_OSPEED_HIGH(GPIOD_GPS_RESET) | \
                                        PIN_OSPEED_HIGH(GPIOD_GPS_RXD) | \
                                        PIN_OSPEED_HIGH(GPIOD_GPS_TXD) | \
                                        PIN_OSPEED_HIGH(GPIOD_PIN7) | \
                                        PIN_OSPEED_HIGH(GPIOD_PIN8) | \
                                        PIN_OSPEED_HIGH(GPIOD_PIN9) | \
                                        PIN_OSPEED_HIGH(GPIOD_LCD_B3) | \
                                        PIN_OSPEED_HIGH(GPIOD_PIN11) | \
                                        PIN_OSPEED_HIGH(GPIOD_LCD_BACKLIGHT) | \
                                        PIN_OSPEED_HIGH(GPIOD_PIN13) | \
                                        PIN_OSPEED_HIGH(GPIOD_PIN14) | \
                                        PIN_OSPEED_HIGH(GPIOD_PIN15))
#define VAL_GPIOD_PUPDR                (PIN_PUPD_PULLUP(GPIOD_PIN0) | \
                                        PIN_PUPD_PULLUP(GPIOD_PIN1) | \
                                        PIN_PUPD_PULLUP(GPIOD_USD_CMD) | \
                                        PIN_PUPD_PULLUP(GPIOD_PIN3) | \
                                        PIN_PUPD_PULLUP(GPIOD_GPS_RESET) | \
                                        PIN_PUPD_PULLUP(GPIOD_GPS_RXD) | \
                                        PIN_PUPD_PULLUP(GPIOD_GPS_TXD) | \
                                        PIN_PUPD_PULLUP(GPIOD_PIN7) | \
                                        PIN_PUPD_PULLUP(GPIOD_PIN8) | \
                                        PIN_PUPD_PULLUP(GPIOD_PIN9) | \
                                        PIN_PUPD_PULLUP(GPIOD_LCD_B3) | \
                                        PIN_PUPD_PULLUP(GPIOD_PIN11) | \
                                        PIN_PUPD_FLOATING(GPIOD_LCD_BACKLIGHT) | \
                                        PIN_PUPD_PULLUP(GPIOD_PIN13) | \
                                        PIN_PUPD_PULLUP(GPIOD_PIN14) | \
                                        PIN_PUPD_PULLUP(GPIOD_PIN15))
#define VAL_GPIOD_ODR                  (PIN_OD_HIGH(GPIOD_PIN0) | \
                                        PIN_OD_HIGH(GPIOD_PIN1) | \
                                        PIN_OD_HIGH(GPIOD_USD_CMD) | \
                                        PIN_OD_HIGH(GPIOD_PIN3) | \
                                        PIN_OD_HIGH(GPIOD_GPS_RESET) | \
                                        PIN_OD_HIGH(GPIOD_GPS_RXD) | \
                                        PIN_OD_HIGH(GPIOD_GPS_TXD) | \
                                        PIN_OD_HIGH(GPIOD_PIN7) | \
                                        PIN_OD_HIGH(GPIOD_PIN8) | \
                                        PIN_OD_HIGH(GPIOD_PIN9) | \
                                        PIN_OD_HIGH(GPIOD_LCD_B3) | \
                                        PIN_OD_HIGH(GPIOD_PIN11) | \
                                        PIN_OD_HIGH(GPIOD_LCD_BACKLIGHT) | \
                                        PIN_OD_HIGH(GPIOD_PIN13) | \
                                        PIN_OD_HIGH(GPIOD_PIN14) | \
                                        PIN_OD_HIGH(GPIOD_PIN15))
#define VAL_GPIOD_AFRL                 (PIN_AFIO_AF(GPIOD_PIN0, 0U) | \
                                        PIN_AFIO_AF(GPIOD_PIN1, 0U) | \
                                        PIN_AFIO_AF(GPIOD_USD_CMD, 12U) | \
                                        PIN_AFIO_AF(GPIOD_PIN3, 0U) | \
                                        PIN_AFIO_AF(GPIOD_GPS_RESET, 0U) | \
                                        PIN_AFIO_AF(GPIOD_GPS_RXD, 7U) | \
                                        PIN_AFIO_AF(GPIOD_GPS_TXD, 7U) | \
                                        PIN_AFIO_AF(GPIOD_PIN7, 0U))
#define VAL_GPIOD_AFRH                 (PIN_AFIO_AF(GPIOD_PIN8, 0U) | \
                                        PIN_AFIO_AF(GPIOD_PIN9, 0U) | \
                                        PIN_AFIO_AF(GPIOD_LCD_B3, 14U) | \
                                        PIN_AFIO_AF(GPIOD_PIN11, 0U) | \
                                        PIN_AFIO_AF(GPIOD_LCD_BACKLIGHT, 2U) | \
                                        PIN_AFIO_AF(GPIOD_PIN13, 0U) | \
                                        PIN_AFIO_AF(GPIOD_PIN14, 0U) | \
                                        PIN_AFIO_AF(GPIOD_PIN15, 0U))

/*
 *  GPIOE setup:
 *
 * PE0  - PIN0                         (unused).
 * PE1  - PIN1                         (unused).
 * PE2  - LCD_SCL                      (af5).
 * PE3  - LCD_DCX                      (output).
 * PE4  - LCD_CS                       (output).
 * PE5  - LCD_RST                      (output).
 * PE6  - LCD_SDA                      (af5).
 * PE7  - PIN7                         (unused).
 * PE8  - PIN8                         (unused).
 * PE9  - PIN9                         (unused).
 * PE10 - PIN10                        (unused).
 * PE11 - LCD_G3                       (af14).
 * PE12 - LCD_B4                       (af14).
 * PE13 - LCD_DE                       (af14).
 * PE14 - LCD_DOTCLK                   (af14).
 * PE15 - LCD_R7                       (af14).
*/
#define VAL_GPIOE_MODER                (PIN_MODE_INPUT(GPIOE_PIN0) | \
                                        PIN_MODE_INPUT(GPIOE_PIN1) | \
                                        PIN_MODE_ALTERNATE(GPIOE_LCD_SCL) | \
                                        PIN_MODE_OUTPUT(GPIOE_LCD_DCX) | \
                                        PIN_MODE_OUTPUT(GPIOE_LCD_CS) | \
                                        PIN_MODE_OUTPUT(GPIOE_LCD_RST) | \
                                        PIN_MODE_ALTERNATE(GPIOE_LCD_SDA) | \
                                        PIN_MODE_INPUT(GPIOE_PIN7) | \
                                        PIN_MODE_INPUT(GPIOE_PIN8) | \
                                        PIN_MODE_INPUT(GPIOE_PIN9) | \
                                        PIN_MODE_INPUT(GPIOE_PIN10) | \
                                        PIN_MODE_ALTERNATE(GPIOE_LCD_G3) | \
                                        PIN_MODE_ALTERNATE(GPIOE_LCD_B4) | \
                                        PIN_MODE_ALTERNATE(GPIOE_LCD_DE) | \
                                        PIN_MODE_ALTERNATE(GPIOE_LCD_DOTCLK) | \
                                        PIN_MODE_ALTERNATE(GPIOE_LCD_R7))
#define VAL_GPIOE_OTYPER               (PIN_OTYPE_PUSHPULL(GPIOE_PIN0) | \
                                        PIN_OTYPE_PUSHPULL(GPIOE_PIN1) | \
                                        PIN_OTYPE_PUSHPULL(GPIOE_LCD_SCL) | \
                                        PIN_OTYPE_PUSHPULL(GPIOE_LCD_DCX) | \
                                        PIN_OTYPE_PUSHPULL(GPIOE_LCD_CS) | \
                                        PIN_OTYPE_PUSHPULL(GPIOE_LCD_RST) | \
                                        PIN_OTYPE_PUSHPULL(GPIOE_LCD_SDA) | \
                                        PIN_OTYPE_PUSHPULL(GPIOE_PIN7) | \
                                        PIN_OTYPE_PUSHPULL(GPIOE_PIN8) | \
                                        PIN_OTYPE_PUSHPULL(GPIOE_PIN9) | \
                                        PIN_OTYPE_PUSHPULL(GPIOE_PIN10) | \
                                        PIN_OTYPE_PUSHPULL(GPIOE_LCD_G3) | \
                                        PIN_OTYPE_PUSHPULL(GPIOE_LCD_B4) | \
                                        PIN_OTYPE_PUSHPULL(GPIOE_LCD_DE) | \
                                        PIN_OTYPE_PUSHPULL(GPIOE_LCD_DOTCLK) | \
                                        PIN_OTYPE_PUSHPULL(GPIOE_LCD_R7))
#define VAL_GPIOE_OSPEEDR              (PIN_OSPEED_HIGH(GPIOE_PIN0) | \
                                        PIN_OSPEED_HIGH(GPIOE_PIN1) | \
                                        PIN_OSPEED_HIGH(GPIOE_LCD_SCL) | \
                                        PIN_OSPEED_HIGH(GPIOE_LCD_DCX) | \
                                        PIN_OSPEED_HIGH(GPIOE_LCD_CS) | \
                                        PIN_OSPEED_HIGH(GPIOE_LCD_RST) | \
                                        PIN_OSPEED_HIGH(GPIOE_LCD_SDA) | \
                                        PIN_OSPEED_HIGH(GPIOE_PIN7) | \
                                        PIN_OSPEED_HIGH(GPIOE_PIN8) | \
                                        PIN_OSPEED_HIGH(GPIOE_PIN9) | \
                                        PIN_OSPEED_HIGH(GPIOE_PIN10) | \
                                        PIN_OSPEED_HIGH(GPIOE_LCD_G3) | \
                                        PIN_OSPEED_HIGH(GPIOE_LCD_B4) | \
                                        PIN_OSPEED_HIGH(GPIOE_LCD_DE) | \
                                        PIN_OSPEED_HIGH(GPIOE_LCD_DOTCLK) | \
                                        PIN_OSPEED_HIGH(GPIOE_LCD_R7))
#define VAL_GPIOE_PUPDR                (PIN_PUPD_PULLUP(GPIOE_PIN0) | \
                                        PIN_PUPD_PULLUP(GPIOE_PIN1) | \
                                        PIN_PUPD_PULLUP(GPIOE_LCD_SCL) | \
                                        PIN_PUPD_PULLUP(GPIOE_LCD_DCX) | \
                                        PIN_PUPD_PULLUP(GPIOE_LCD_CS) | \
                                        PIN_PUPD_PULLUP(GPIOE_LCD_RST) | \
                                        PIN_PUPD_PULLUP(GPIOE_LCD_SDA) | \
                                        PIN_PUPD_PULLUP(GPIOE_PIN7) | \
                                        PIN_PUPD_PULLUP(GPIOE_PIN8) | \
                                        PIN_PUPD_PULLUP(GPIOE_PIN9) | \
                                        PIN_PUPD_PULLUP(GPIOE_PIN10) | \
                                        PIN_PUPD_PULLUP(GPIOE_LCD_G3) | \
                                        PIN_PUPD_PULLUP(GPIOE_LCD_B4) | \
                                        PIN_PUPD_PULLUP(GPIOE_LCD_DE) | \
                                        PIN_PUPD_PULLUP(GPIOE_LCD_DOTCLK) | \
                                        PIN_PUPD_PULLUP(GPIOE_LCD_R7))
#define VAL_GPIOE_ODR                  (PIN_OD_HIGH(GPIOE_PIN0) | \
                                        PIN_OD_HIGH(GPIOE_PIN1) | \
                                        PIN_OD_HIGH(GPIOE_LCD_SCL) | \
                                        PIN_OD_HIGH(GPIOE_LCD_DCX) | \
                                        PIN_OD_HIGH(GPIOE_LCD_CS) | \
                                        PIN_OD_HIGH(GPIOE_LCD_RST) | \
                                        PIN_OD_HIGH(GPIOE_LCD_SDA) | \
                                        PIN_OD_HIGH(GPIOE_PIN7) | \
                                        PIN_OD_HIGH(GPIOE_PIN8) | \
                                        PIN_OD_HIGH(GPIOE_PIN9) | \
                                        PIN_OD_HIGH(GPIOE_PIN10) | \
                                        PIN_OD_HIGH(GPIOE_LCD_G3) | \
                                        PIN_OD_HIGH(GPIOE_LCD_B4) | \
                                        PIN_OD_HIGH(GPIOE_LCD_DE) | \
                                        PIN_OD_HIGH(GPIOE_LCD_DOTCLK) | \
                                        PIN_OD_HIGH(GPIOE_LCD_R7))
#define VAL_GPIOE_AFRL                 (PIN_AFIO_AF(GPIOE_PIN0, 0U) | \
                                        PIN_AFIO_AF(GPIOE_PIN1, 0U) | \
                                        PIN_AFIO_AF(GPIOE_LCD_SCL, 5U) | \
                                        PIN_AFIO_AF(GPIOE_LCD_DCX, 0U) | \
                                        PIN_AFIO_AF(GPIOE_LCD_CS, 0U) | \
                                        PIN_AFIO_AF(GPIOE_LCD_RST, 0U) | \
                                        PIN_AFIO_AF(GPIOE_LCD_SDA, 5U) | \
                                        PIN_AFIO_AF(GPIOE_PIN7, 0U))
#define VAL_GPIOE_AFRH                 (PIN_AFIO_AF(GPIOE_PIN8, 0U) | \
                                        PIN_AFIO_AF(GPIOE_PIN9, 0U) | \
                                        PIN_AFIO_AF(GPIOE_PIN10, 0U) | \
                                        PIN_AFIO_AF(GPIOE_LCD_G3, 14U) | \
                                        PIN_AFIO_AF(GPIOE_LCD_B4, 14U) | \
                                        PIN_AFIO_AF(GPIOE_LCD_DE, 14U) | \
                                        PIN_AFIO_AF(GPIOE_LCD_DOTCLK, 14U) | \
                                        PIN_AFIO_AF(GPIOE_LCD_R7, 14U))

/*
 *  GPIOF setup:
 *
 * PF0  - PIN0                         (unused).
 * PF1  - PIN1                         (unused).
 * PF2  - PIN2                         (unused).
 * PF3  - BATT_I_CHG                   (floating, analog).
 * PF4  - BATT_V_MON                   (floating, analog).
 * PF5  - TOUCH_INT                    ().
 * PF6  - TOUCH_CS                     (output).
 * PF7  - TOUCH_SCK                    (af5).
 * PF8  - TOUCH_SDO                    (af5).
 * PF9  - TOUCH_SDI                    (af5).
 * PF10 - EEPROM_CS                    (output).
 * PF11 - PIN11                        (unused).
 * PF12 - PIN12                        (unused).
 * PF13 - PIN13                        (unused).
 * PF14 - PIN14                        (unused).
 * PF15 - PIN15                        (unused).
*/
#define VAL_GPIOF_MODER                (PIN_MODE_INPUT(GPIOF_PIN0) | \
                                        PIN_MODE_INPUT(GPIOF_PIN1) | \
                                        PIN_MODE_INPUT(GPIOF_PIN2) | \
                                        PIN_MODE_ANALOG(GPIOF_BATT_I_CHG) | \
                                        PIN_MODE_ANALOG(GPIOF_BATT_V_MON) | \
                                        PIN_MODE_INPUT(GPIOF_TOUCH_INT) | \
                                        PIN_MODE_OUTPUT(GPIOF_TOUCH_CS) | \
                                        PIN_MODE_ALTERNATE(GPIOF_TOUCH_SCK) | \
                                        PIN_MODE_ALTERNATE(GPIOF_TOUCH_SDO) | \
                                        PIN_MODE_ALTERNATE(GPIOF_TOUCH_SDI) | \
                                        PIN_MODE_OUTPUT(GPIOF_EEPROM_CS) | \
                                        PIN_MODE_INPUT(GPIOF_PIN11) | \
                                        PIN_MODE_INPUT(GPIOF_PIN12) | \
                                        PIN_MODE_INPUT(GPIOF_PIN13) | \
                                        PIN_MODE_INPUT(GPIOF_PIN14) | \
                                        PIN_MODE_INPUT(GPIOF_PIN15))
#define VAL_GPIOF_OTYPER               (PIN_OTYPE_PUSHPULL(GPIOF_PIN0) | \
                                        PIN_OTYPE_PUSHPULL(GPIOF_PIN1) | \
                                        PIN_OTYPE_PUSHPULL(GPIOF_PIN2) | \
                                        PIN_OTYPE_PUSHPULL(GPIOF_BATT_I_CHG) | \
                                        PIN_OTYPE_PUSHPULL(GPIOF_BATT_V_MON) | \
                                        PIN_OTYPE_PUSHPULL(GPIOF_TOUCH_INT) | \
                                        PIN_OTYPE_PUSHPULL(GPIOF_TOUCH_CS) | \
                                        PIN_OTYPE_PUSHPULL(GPIOF_TOUCH_SCK) | \
                                        PIN_OTYPE_PUSHPULL(GPIOF_TOUCH_SDO) | \
                                        PIN_OTYPE_PUSHPULL(GPIOF_TOUCH_SDI) | \
                                        PIN_OTYPE_PUSHPULL(GPIOF_EEPROM_CS) | \
                                        PIN_OTYPE_PUSHPULL(GPIOF_PIN11) | \
                                        PIN_OTYPE_PUSHPULL(GPIOF_PIN12) | \
                                        PIN_OTYPE_PUSHPULL(GPIOF_PIN13) | \
                                        PIN_OTYPE_PUSHPULL(GPIOF_PIN14) | \
                                        PIN_OTYPE_PUSHPULL(GPIOF_PIN15))
#define VAL_GPIOF_OSPEEDR              (PIN_OSPEED_HIGH(GPIOF_PIN0) | \
                                        PIN_OSPEED_HIGH(GPIOF_PIN1) | \
                                        PIN_OSPEED_HIGH(GPIOF_PIN2) | \
                                        PIN_OSPEED_HIGH(GPIOF_BATT_I_CHG) | \
                                        PIN_OSPEED_HIGH(GPIOF_BATT_V_MON) | \
                                        PIN_OSPEED_HIGH(GPIOF_TOUCH_INT) | \
                                        PIN_OSPEED_HIGH(GPIOF_TOUCH_CS) | \
                                        PIN_OSPEED_HIGH(GPIOF_TOUCH_SCK) | \
                                        PIN_OSPEED_HIGH(GPIOF_TOUCH_SDO) | \
                                        PIN_OSPEED_HIGH(GPIOF_TOUCH_SDI) | \
                                        PIN_OSPEED_HIGH(GPIOF_EEPROM_CS) | \
                                        PIN_OSPEED_HIGH(GPIOF_PIN11) | \
                                        PIN_OSPEED_HIGH(GPIOF_PIN12) | \
                                        PIN_OSPEED_HIGH(GPIOF_PIN13) | \
                                        PIN_OSPEED_HIGH(GPIOF_PIN14) | \
                                        PIN_OSPEED_HIGH(GPIOF_PIN15))
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
                                        PIN_AFIO_AF(GPIOF_PIN12, 0U) | \
                                        PIN_AFIO_AF(GPIOF_PIN13, 0U) | \
                                        PIN_AFIO_AF(GPIOF_PIN14, 0U) | \
                                        PIN_AFIO_AF(GPIOF_PIN15, 0U))

/*
 *  GPIOG setup:
 *
 * PG0  - PIN0                         (unused).
 * PG1  - PIN1                         (unused).
 * PG2  - PIN2                         (unused).
 * PG3  - PIN3                         (unused).
 * PG4  - PIN4                         (unused).
 * PG5  - PIN5                         (unused).
 * PG6  - PIN6                         (unused).
 * PG7  - PIN7                         (unused).
 * PG8  - LCD_G7                       (af14).
 * PG9  - PIN9                         (unused).
 * PG10 - LCD_B2                       (af14).
 * PG11 - RMII_TX_EN                   (af11).
 * PG12 - PIN12                        (unused).
 * PG13 - RMII_TXD0                    (af11).
 * PG14 - RMII_TXD1                    (af11).
 * PG15 - PIN15                        (unused).
*/
#define VAL_GPIOG_MODER                (PIN_MODE_INPUT(GPIOG_PIN0) | \
                                        PIN_MODE_INPUT(GPIOG_PIN1) | \
                                        PIN_MODE_INPUT(GPIOG_PIN2) | \
                                        PIN_MODE_INPUT(GPIOG_PIN3) | \
                                        PIN_MODE_INPUT(GPIOG_PIN4) | \
                                        PIN_MODE_INPUT(GPIOG_PIN5) | \
                                        PIN_MODE_INPUT(GPIOG_PIN6) | \
                                        PIN_MODE_INPUT(GPIOG_PIN7) | \
                                        PIN_MODE_ALTERNATE(GPIOG_LCD_G7) | \
                                        PIN_MODE_INPUT(GPIOG_PIN9) | \
                                        PIN_MODE_ALTERNATE(GPIOG_LCD_B2) | \
                                        PIN_MODE_ALTERNATE(GPIOG_RMII_TX_EN) | \
                                        PIN_MODE_INPUT(GPIOG_PIN12) | \
                                        PIN_MODE_ALTERNATE(GPIOG_RMII_TXD0) | \
                                        PIN_MODE_ALTERNATE(GPIOG_RMII_TXD1) | \
                                        PIN_MODE_INPUT(GPIOG_PIN15))
#define VAL_GPIOG_OTYPER               (PIN_OTYPE_PUSHPULL(GPIOG_PIN0) | \
                                        PIN_OTYPE_PUSHPULL(GPIOG_PIN1) | \
                                        PIN_OTYPE_PUSHPULL(GPIOG_PIN2) | \
                                        PIN_OTYPE_PUSHPULL(GPIOG_PIN3) | \
                                        PIN_OTYPE_PUSHPULL(GPIOG_PIN4) | \
                                        PIN_OTYPE_PUSHPULL(GPIOG_PIN5) | \
                                        PIN_OTYPE_PUSHPULL(GPIOG_PIN6) | \
                                        PIN_OTYPE_PUSHPULL(GPIOG_PIN7) | \
                                        PIN_OTYPE_PUSHPULL(GPIOG_LCD_G7) | \
                                        PIN_OTYPE_PUSHPULL(GPIOG_PIN9) | \
                                        PIN_OTYPE_PUSHPULL(GPIOG_LCD_B2) | \
                                        PIN_OTYPE_PUSHPULL(GPIOG_RMII_TX_EN) | \
                                        PIN_OTYPE_PUSHPULL(GPIOG_PIN12) | \
                                        PIN_OTYPE_PUSHPULL(GPIOG_RMII_TXD0) | \
                                        PIN_OTYPE_PUSHPULL(GPIOG_RMII_TXD1) | \
                                        PIN_OTYPE_PUSHPULL(GPIOG_PIN15))
#define VAL_GPIOG_OSPEEDR              (PIN_OSPEED_HIGH(GPIOG_PIN0) | \
                                        PIN_OSPEED_HIGH(GPIOG_PIN1) | \
                                        PIN_OSPEED_HIGH(GPIOG_PIN2) | \
                                        PIN_OSPEED_HIGH(GPIOG_PIN3) | \
                                        PIN_OSPEED_HIGH(GPIOG_PIN4) | \
                                        PIN_OSPEED_HIGH(GPIOG_PIN5) | \
                                        PIN_OSPEED_HIGH(GPIOG_PIN6) | \
                                        PIN_OSPEED_HIGH(GPIOG_PIN7) | \
                                        PIN_OSPEED_HIGH(GPIOG_LCD_G7) | \
                                        PIN_OSPEED_HIGH(GPIOG_PIN9) | \
                                        PIN_OSPEED_HIGH(GPIOG_LCD_B2) | \
                                        PIN_OSPEED_HIGH(GPIOG_RMII_TX_EN) | \
                                        PIN_OSPEED_HIGH(GPIOG_PIN12) | \
                                        PIN_OSPEED_HIGH(GPIOG_RMII_TXD0) | \
                                        PIN_OSPEED_HIGH(GPIOG_RMII_TXD1) | \
                                        PIN_OSPEED_HIGH(GPIOG_PIN15))
#define VAL_GPIOG_PUPDR                (PIN_PUPD_PULLUP(GPIOG_PIN0) | \
                                        PIN_PUPD_PULLUP(GPIOG_PIN1) | \
                                        PIN_PUPD_PULLUP(GPIOG_PIN2) | \
                                        PIN_PUPD_PULLUP(GPIOG_PIN3) | \
                                        PIN_PUPD_PULLUP(GPIOG_PIN4) | \
                                        PIN_PUPD_PULLUP(GPIOG_PIN5) | \
                                        PIN_PUPD_PULLUP(GPIOG_PIN6) | \
                                        PIN_PUPD_PULLUP(GPIOG_PIN7) | \
                                        PIN_PUPD_PULLUP(GPIOG_LCD_G7) | \
                                        PIN_PUPD_PULLUP(GPIOG_PIN9) | \
                                        PIN_PUPD_PULLUP(GPIOG_LCD_B2) | \
                                        PIN_PUPD_FLOATING(GPIOG_RMII_TX_EN) | \
                                        PIN_PUPD_PULLUP(GPIOG_PIN12) | \
                                        PIN_PUPD_FLOATING(GPIOG_RMII_TXD0) | \
                                        PIN_PUPD_FLOATING(GPIOG_RMII_TXD1) | \
                                        PIN_PUPD_PULLUP(GPIOG_PIN15))
#define VAL_GPIOG_ODR                  (PIN_OD_HIGH(GPIOG_PIN0) | \
                                        PIN_OD_HIGH(GPIOG_PIN1) | \
                                        PIN_OD_HIGH(GPIOG_PIN2) | \
                                        PIN_OD_HIGH(GPIOG_PIN3) | \
                                        PIN_OD_HIGH(GPIOG_PIN4) | \
                                        PIN_OD_HIGH(GPIOG_PIN5) | \
                                        PIN_OD_HIGH(GPIOG_PIN6) | \
                                        PIN_OD_HIGH(GPIOG_PIN7) | \
                                        PIN_OD_HIGH(GPIOG_LCD_G7) | \
                                        PIN_OD_HIGH(GPIOG_PIN9) | \
                                        PIN_OD_HIGH(GPIOG_LCD_B2) | \
                                        PIN_OD_HIGH(GPIOG_RMII_TX_EN) | \
                                        PIN_OD_HIGH(GPIOG_PIN12) | \
                                        PIN_OD_HIGH(GPIOG_RMII_TXD0) | \
                                        PIN_OD_HIGH(GPIOG_RMII_TXD1) | \
                                        PIN_OD_HIGH(GPIOG_PIN15))
#define VAL_GPIOG_AFRL                 (PIN_AFIO_AF(GPIOG_PIN0, 0U) | \
                                        PIN_AFIO_AF(GPIOG_PIN1, 0U) | \
                                        PIN_AFIO_AF(GPIOG_PIN2, 0U) | \
                                        PIN_AFIO_AF(GPIOG_PIN3, 0U) | \
                                        PIN_AFIO_AF(GPIOG_PIN4, 0U) | \
                                        PIN_AFIO_AF(GPIOG_PIN5, 0U) | \
                                        PIN_AFIO_AF(GPIOG_PIN6, 0U) | \
                                        PIN_AFIO_AF(GPIOG_PIN7, 0U))
#define VAL_GPIOG_AFRH                 (PIN_AFIO_AF(GPIOG_LCD_G7, 14U) | \
                                        PIN_AFIO_AF(GPIOG_PIN9, 0U) | \
                                        PIN_AFIO_AF(GPIOG_LCD_B2, 14U) | \
                                        PIN_AFIO_AF(GPIOG_RMII_TX_EN, 11U) | \
                                        PIN_AFIO_AF(GPIOG_PIN12, 0U) | \
                                        PIN_AFIO_AF(GPIOG_RMII_TXD0, 11U) | \
                                        PIN_AFIO_AF(GPIOG_RMII_TXD1, 11U) | \
                                        PIN_AFIO_AF(GPIOG_PIN15, 0U))

/*
 *  GPIOH setup:
 *
 * PH0  - CS2100_CLK                   (floating).
 * PH1  - PIN1                         (unused).
 * PH2  - PIN2                         (unused).
 * PH3  - PIN3                         (unused).
 * PH4  - PIN4                         (unused).
 * PH5  - PIN5                         (unused).
 * PH6  - PIN6                         (unused).
 * PH7  - PIN7                         (unused).
 * PH8  - PIN8                         (unused).
 * PH9  - PIN9                         (unused).
 * PH10 - PIN10                        (unused).
 * PH11 - PIN11                        (unused).
 * PH12 - PIN12                        (unused).
 * PH13 - PIN13                        (unused).
 * PH14 - PIN14                        (unused).
 * PH15 - PIN15                        (unused).
*/
#define VAL_GPIOH_MODER                (PIN_MODE_INPUT(GPIOH_CS2100_CLK) | \
                                        PIN_MODE_INPUT(GPIOH_PIN1) | \
                                        PIN_MODE_INPUT(GPIOH_PIN2) | \
                                        PIN_MODE_INPUT(GPIOH_PIN3) | \
                                        PIN_MODE_INPUT(GPIOH_PIN4) | \
                                        PIN_MODE_INPUT(GPIOH_PIN5) | \
                                        PIN_MODE_INPUT(GPIOH_PIN6) | \
                                        PIN_MODE_INPUT(GPIOH_PIN7) | \
                                        PIN_MODE_INPUT(GPIOH_PIN8) | \
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
                                        PIN_OD_HIGH(GPIOK_PIN2) | \
                                        PIN_OD_HIGH(GPIOK_PIN3) | \
                                        PIN_OD_HIGH(GPIOK_PIN4) | \
                                        PIN_OD_HIGH(GPIOK_PIN5) | \
                                        PIN_OD_HIGH(GPIOK_PIN6) | \
                                        PIN_OD_HIGH(GPIOK_PIN7) | \
                                        PIN_OD_HIGH(GPIOK_PIN8) | \
                                        PIN_OD_HIGH(GPIOK_PIN9) | \
                                        PIN_OD_HIGH(GPIOK_PIN10) | \
                                        PIN_OD_HIGH(GPIOK_PIN11) | \
                                        PIN_OD_HIGH(GPIOK_PIN12) | \
                                        PIN_OD_HIGH(GPIOK_PIN13) | \
                                        PIN_OD_HIGH(GPIOK_PIN14) | \
                                        PIN_OD_HIGH(GPIOK_PIN15))
#define VAL_GPIOK_AFRL                 (PIN_AFIO_AF(GPIOK_PIN0, 0U) | \
                                        PIN_AFIO_AF(GPIOK_PIN1, 0U) | \
                                        PIN_AFIO_AF(GPIOK_PIN2, 0U) | \
                                        PIN_AFIO_AF(GPIOK_PIN3, 0U) | \
                                        PIN_AFIO_AF(GPIOK_PIN4, 0U) | \
                                        PIN_AFIO_AF(GPIOK_PIN5, 0U) | \
                                        PIN_AFIO_AF(GPIOK_PIN6, 0U) | \
                                        PIN_AFIO_AF(GPIOK_PIN7, 0U))
#define VAL_GPIOK_AFRH                 (PIN_AFIO_AF(GPIOK_PIN8, 0U) | \
                                        PIN_AFIO_AF(GPIOK_PIN9, 0U) | \
                                        PIN_AFIO_AF(GPIOK_PIN10, 0U) | \
                                        PIN_AFIO_AF(GPIOK_PIN11, 0U) | \
                                        PIN_AFIO_AF(GPIOK_PIN12, 0U) | \
                                        PIN_AFIO_AF(GPIOK_PIN13, 0U) | \
                                        PIN_AFIO_AF(GPIOK_PIN14, 0U) | \
                                        PIN_AFIO_AF(GPIOK_PIN15, 0U))

#if !defined(_FROM_ASM_)
#ifdef __cplusplus
extern "C" {
#endif
  void boardInit(void);
#ifdef __cplusplus
}
#endif
#endif /* _FROM_ASM_ */

#endif /* _BOARD_H_ */
