adamgreig/linetime/firmware/measurements.h

#ifndef LINETIME_MEASUREMENTS_H
#define LINETIME_MEASUREMENTS_H

#include <stdint.h>

void measurements_init(void);

struct mains_cycle {
    /* Measured RMS voltage, in 2^-7 volts (UQ9.7). */
    uint16_t rms;

    /* UTC time of PPS immediately before cycle initial zero crossing.
     * utc_year is years-since-2000.
     */
    uint8_t utc_year, utc_month, utc_day, utc_hour, utc_minute, utc_second;

    /* Nanoseconds since last PPS. */
    uint32_t nanoseconds;

    /* Measured period, in nanoseconds. */
    uint32_t period_ns;
};

struct mains_waveform {
    union {
        /* UTC time of PPS pulse immediately before first sample.
         * utc_year is years-since-2000.
         */
        struct { uint8_t utc_year, utc_month, utc_day,
                         utc_hour, utc_minute, utc_second; };

        /* Internal use only. Sorry. Pretend this isn't here. */
        struct { uint32_t _pps_timestamp; uint32_t _x; };
    };

    /* Nanoseconds between last PPS and first sample. */
    uint32_t nanoseconds;

    /* Waveform sampled at 1ks/s. */
    int8_t waveform[128];
};

struct ublox_pps {
    /* Free running nanosecond counter value at PPS instant */
    uint32_t nanoseconds;
};

/* Time synchronisation tools */
extern event_source_t measurements_pps_evt;
extern volatile uint32_t *const measurements_dimiseconds;

#endif
