adamgreig/linetime/(commit log)

2016-12-10 WIP. Saving ethernet sheet before I take out PoE.
    [linetime.kicad_pcb, linetime.sch, linetime_battery.sch, linetime_ethernet.sch, linetime_gps.sch, linetime_mains.sch, linetime_ui.sch]
2016-12-14 schematic basically done...
    [linetime.sch, linetime_battery.sch, linetime_ethernet.sch, linetime_gps.sch, linetime_mains.sch, linetime_ui.sch]
2016-12-16 WIP routing
    [linetime.kicad_pcb, linetime.sch, linetime_battery.sch, linetime_ethernet.sch, linetime_gps.sch, linetime_mains.sch, linetime_ui.sch]
2016-12-18 22 airwires to go
    [linetime.kicad_pcb, linetime.sch, linetime_battery.sch, linetime_ethernet.sch, linetime_gps.sch, linetime_mains.sch, linetime_ui.sch]
2016-12-18 17 airwires
    [linetime.kicad_pcb]
2016-12-18 4 to go!!
    [linetime.kicad_pcb]
2016-12-18 565RGB and 2 airwires left yay
    [linetime.kicad_pcb]
2016-12-19 cleaned up all the fast lines
    [linetime.kicad_pcb, linetime.sch, linetime_battery.sch, linetime_ethernet.sch, linetime_gps.sch, linetime_mains.sch, linetime_ui.sch]
2016-12-19 goodness. routed all airwires.
    [linetime.kicad_pcb]
2016-12-19 gerbers to manufacturing. gulp.
    [linetime.kicad_pcb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]
2016-12-21 add farnell part numbers for passives
    [linetime.sch, linetime_battery.sch, linetime_ethernet.sch, linetime_gps.sch, linetime_mains.sch, linetime_ui.sch]
2016-12-24 untested gps driver
2016-12-24 add untested cs2100 config and clock swapping stuff
    [cs2100.c, main.c, mcuconf.h, ublox.c, ublox.h]
2016-12-27 grab waveform at half/full adc dma interrupts and subsample
2016-12-30 tweak ublox, cs2100, etc, etc, to get board up and running
2016-12-30 fix more timer issues
    [board.c, chconf.h, measurements.c, microsd.c, ublox.c]
2017-01-02 add prototype view/count script
2017-01-02 update to 100MHz timer
2017-01-06 reduce draw window size to prevent weird issue
    [main.c]
2017-01-15 diyeth mostly done? see msg
    so.. everything is awful
    *) need to __DMB() while interacting with the eth descriptors when in SRAM1/2
    or weird things happen, as well as needing cache off/disabled by MPU/managed
    *) once you do __DMB() you can use SRAM1/2 without issue, just as good as DTCM
    *) however still terrible packet loss on linetime
    *) packet loss is always due to bad FSC due to RXD0 bit flips
    *) bit flips always the LSb in a nibble, always 0->1, and only seem to occur
    in certain places
    *) but no obvious way to predict or correct for them
    *) not clear what the incidence rate of the broken packets is either,
    seems to depend on reception rate and other factors
    *) no effect on transm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
    [compare.py, main.c, netudp.py]
2017-01-22 fix chibios mac mem sync
    [board.h, cs2100.c, gui.c, main.c, ublox.c]
2017-03-29 add case drawing stuff
    [back-panel.dxf, bracket.stl, export.dxf, front_panel.dxf]
2017-04-25 wait for pll off before swapping pll source
    [cs2100.c]
2017-05-08 fix up lcd clock
    [cs2100.c, lcd.c]
2017-05-08 fix cache cleaning in diyeth
    [main.c]
