adamgreig/linetime/(notices)

Notices in the files:
firmware/lwipopts.h:
Copyright (c) 2001-2004 Swedish Institute of Computer Science.
All rights reserved.
